CarlitosssT/Tesis-Senecabot/simulacion/geometry_opt/results/linkage_v0218_br_maps.png

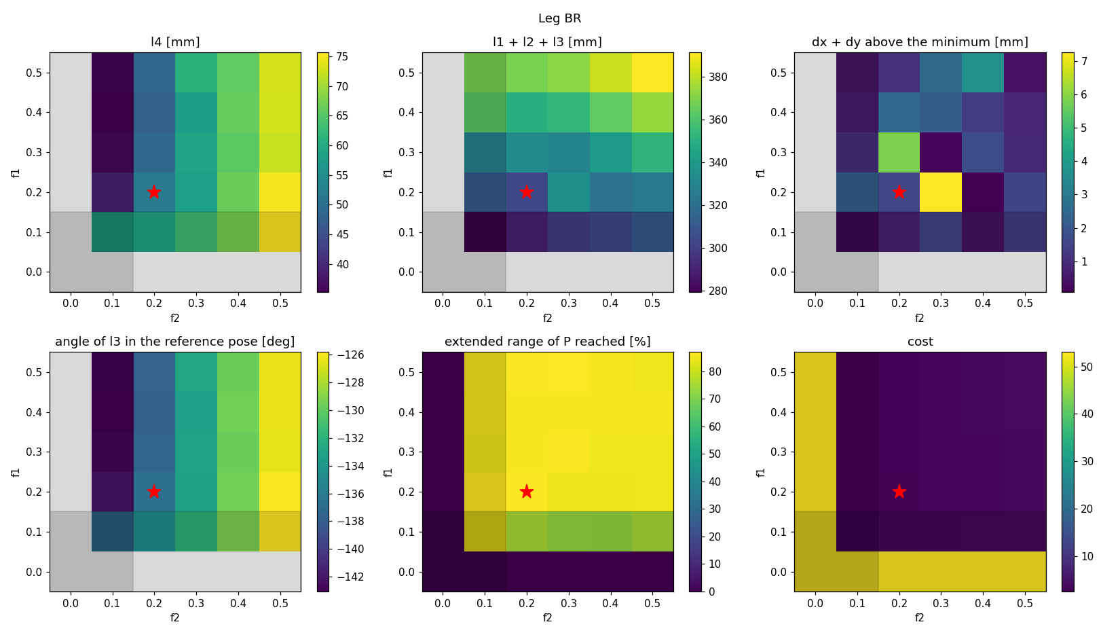
simulacion/geometry_opt/results/linkage_v0218_br_maps.png
