CarlitosssT/Tesis-Senecabot/simulacion/geometry_opt/results/linkage_v140_br_maps.png

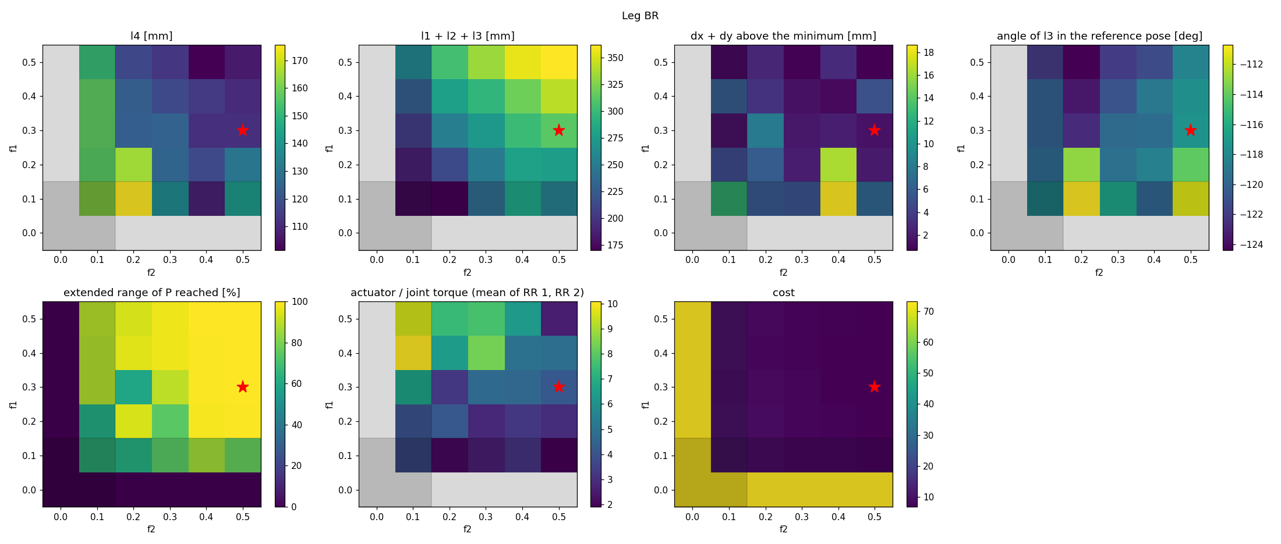
simulacion/geometry_opt/results/linkage_v140_br_maps.png
