CarlitosssT/Tesis-Senecabot/hardware/leg_transmission/leg_motor_angles_one_cycle.csv

time_s | fr_hip_motor | fr_knee_motor | fr_ankle_motor | fl_hip_motor | fl_knee_motor | fl_ankle_motor | br_hip_motor | br_knee_motor | br_ankle_motor | bl_hip_motor | bl_knee_motor | bl_ankle_motor
0.0000 | 40.8251 | -51.0142 | 89.8326 | 55.4209 | -70.9302 | 35.4565 | -46.0505 | 68.4983 | 22.8941 | -43.3910 | 51.2754 | -10.1909
0.0050 | 40.7122 | -51.6700 | 90.8439 | 55.8056 | -71.0176 | 34.5512 | -45.8379 | 68.3587 | 22.1993 | -43.7348 | 50.6002 | -8.2899
0.0100 | 40.5871 | -52.4167 | 91.5073 | 56.1748 | -71.1229 | 33.5724 | -45.6531 | 68.1821 | 21.4969 | -44.0610 | 50.0015 | -6.2978
0.0150 | 40.4487 | -53.2486 | 91.8306 | 56.5272 | -71.2411 | 32.5229 | -45.4947 | 67.9662 | 20.7894 | -44.3673 | 49.4919 | -4.2333
0.0200 | 40.2975 | -54.1578 | 91.8277 | 56.8616 | -71.3657 | 31.4085 | -45.3610 | 67.7095 | 20.0787 | -44.6524 | 49.0823 | -2.1155
0.0250 | 40.1349 | -55.1345 | 91.5180 | 57.1771 | -71.4888 | 30.2372 | -45.2497 | 67.4121 | 19.3661 | -44.9158 | 48.7815 | 0.0364
0.0300 | 39.9638 | -56.1668 | 90.9264 | 57.4729 | -71.6016 | 29.0190 | -45.1584 | 67.0748 | 18.6526 | -45.1581 | 48.5968 | 2.2037
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
