CarlitosssT/Tesis-Senecabot/hardware/myactuator_esp32/track_fr_hip_motor_20261106_103421.csv

t_cmd_s | cmd_deg | t_meas_s | meas_deg | ref_deg | error_deg
3e-06 | 40.83 | 0.000768 | 40.89 | 40.807758559999996 | 0.08224144000000422
0.005006 | 40.71 | 0.005777 | 40.89 | 40.692759460000005 | 0.1972405399999957
0.010006 | 40.59 | 0.010777 | 40.89 | 40.56559264 | 0.32440736000000214
0.015006 | 40.45 | 0.015777 | 40.89 | 40.425203520000004 | 0.46479647999999685
0.020006 | 40.3 | 0.020777 | 40.88 | 40.27223196 | 0.6077680400000034
0.025006 | 40.13 | 0.025777 | 40.88 | 40.10831106 | 0.7716889400000042
0.030006 | 39.96 | 0.030777 | 40.88 | 39.93651176 | 0.9434882400000006
0.035006 | 39.79 | 0.035777 | 40.87 | 39.760958380000005 | 1.1090416199999922
0.040006 | 39.61 | 0.040777 | 40.87 | 39.5866374 | 1.2833625999999967
0.045006 | 39.44 | 0.045777 | 40.87 | 39.41961098 | 1.4503890199999958
0.050006 | 39.29 | 0.050777 | 40.85 | 39.26635682 | 1.5836431800000028
0.055006 | 39.15 | 0.055759 | 40.85 | 39.13414128 | 1.71585872
0.060003 | 39.04 | 0.060774 | 40.84 | 39.02854944 | 1.8114505600000044
0.065006 | 38.96 | 0.065777 | 40.83 | 38.957379259999996 | 1.8726207400000021
0.070003 | 38.93 | 0.070756 | 40.82 | 38.92616768 | 1.8938323200000013
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
