CarlitosssT/Tesis-Senecabot/hardware/servos/leg_actuator_angles_one_cycle_smooth_n4.csv

time_s | fr_hip_joint | fr_knee_joint | fr_ankle_joint | fl_hip_joint | fl_knee_joint | fl_ankle_joint | br_hip_joint | br_knee_joint | br_ankle_joint | bl_hip_joint | bl_knee_joint | bl_ankle_joint
0.0 | 40.38701487145325 | 92.06070460431222 | 139.68104024879875 | 55.420933 | 126.35109 | 106.38661 | -46.05054 | -114.548874 | -45.60422 | -43.391018 | -94.66641 | -61.466324
0.005 | 40.33558154016885 | 92.52249022583622 | 141.58028578366734 | 55.80559 | 126.823204 | 105.56879 | -45.83786 | -114.1966 | -46.159462 | -43.73483 | -94.335 | -58.890053
0.01 | 40.26754457297821 | 93.08010191479913 | 143.19520915706553 | 56.1748 | 127.29768 | 104.69525 | -45.653084 | -113.83523 | -46.68527 | -44.061005 | -94.06254 | -56.299305
0.015 | 40.18236534982674 | 93.72684785525466 | 144.52798296741648 | 56.527184 | 127.76824 | 103.76399 | -45.49474 | -113.460915 | -47.176815 | -44.367332 | -93.85924 | -53.725178
0.02 | 40.08076920536901 | 94.45440229863391 | 145.58548784768666 | 56.861595 | 128.22725 | 102.77416 | -45.36099 | -113.07054 | -47.630898 | -44.65241 | -93.73466 | -51.197746
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
