CarlitosssT/Tesis-Senecabot/hardware/servos/leg_actuator_angles_trajectory_adapted.csv

time_s | fr_hip_joint | fr_knee_joint | fr_ankle_joint | fl_hip_joint | fl_knee_joint | fl_ankle_joint | br_hip_joint | br_knee_joint | br_ankle_joint | bl_hip_joint | bl_knee_joint | bl_ankle_joint
0.0 | 40.82513 | 91.839325 | 140.84676 | 55.420933 | 126.35109 | 106.38661 | -46.05054 | -114.548874 | -45.60422 | -43.391018 | -94.66641 | -61.466324
0.005 | 40.71224 | 92.3822 | 142.51387 | 55.80559 | 126.823204 | 105.56879 | -45.83786 | -114.1966 | -46.159462 | -43.73483 | -94.335 | -58.890053
0.01 | 40.58707 | 93.003784 | 143.92398 | 56.1748 | 127.29768 | 104.69525 | -45.653084 | -113.83523 | -46.68527 | -44.061005 | -94.06254 | -56.299305
0.015 | 40.44872 | 93.69732 | 145.07922 | 56.527184 | 127.76824 | 103.76399 | -45.49474 | -113.460915 | -47.176815 | -44.367332 | -93.85924 | -53.725178
0.02 | 40.297466 | 94.455315 | 145.9855 | 56.861595 | 128.22725 | 102.77416 | -45.36099 | -113.07054 | -47.630898 | -44.65241 | -93.73466 | -51.197746
0.025 | 40.134907 | 95.26939 | 146.65251 | 57.17709 | 128.66591 | 101.726006 | -45.249664 | -112.6618 | -48.04599 | -44.915833 | -93.69737 | -48.745155
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
