CarlitosssT/Tesis-Senecabot/hardware/leg_transmission/leg_transmission.png

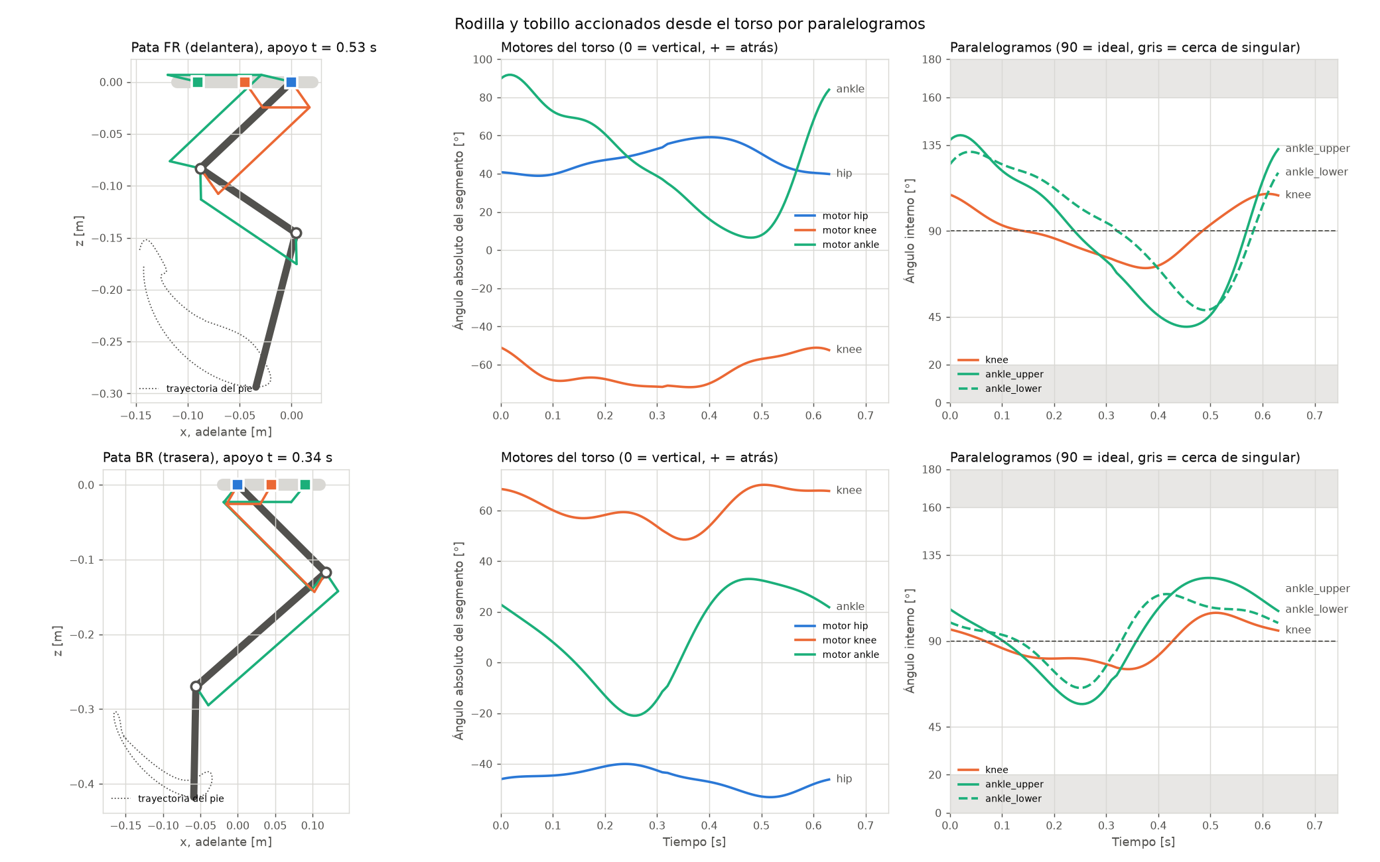
hardware/leg_transmission/leg_transmission.png
