CarlitosssT/Tesis-Senecabot/hardware/leg_transmission/mecanismo.png

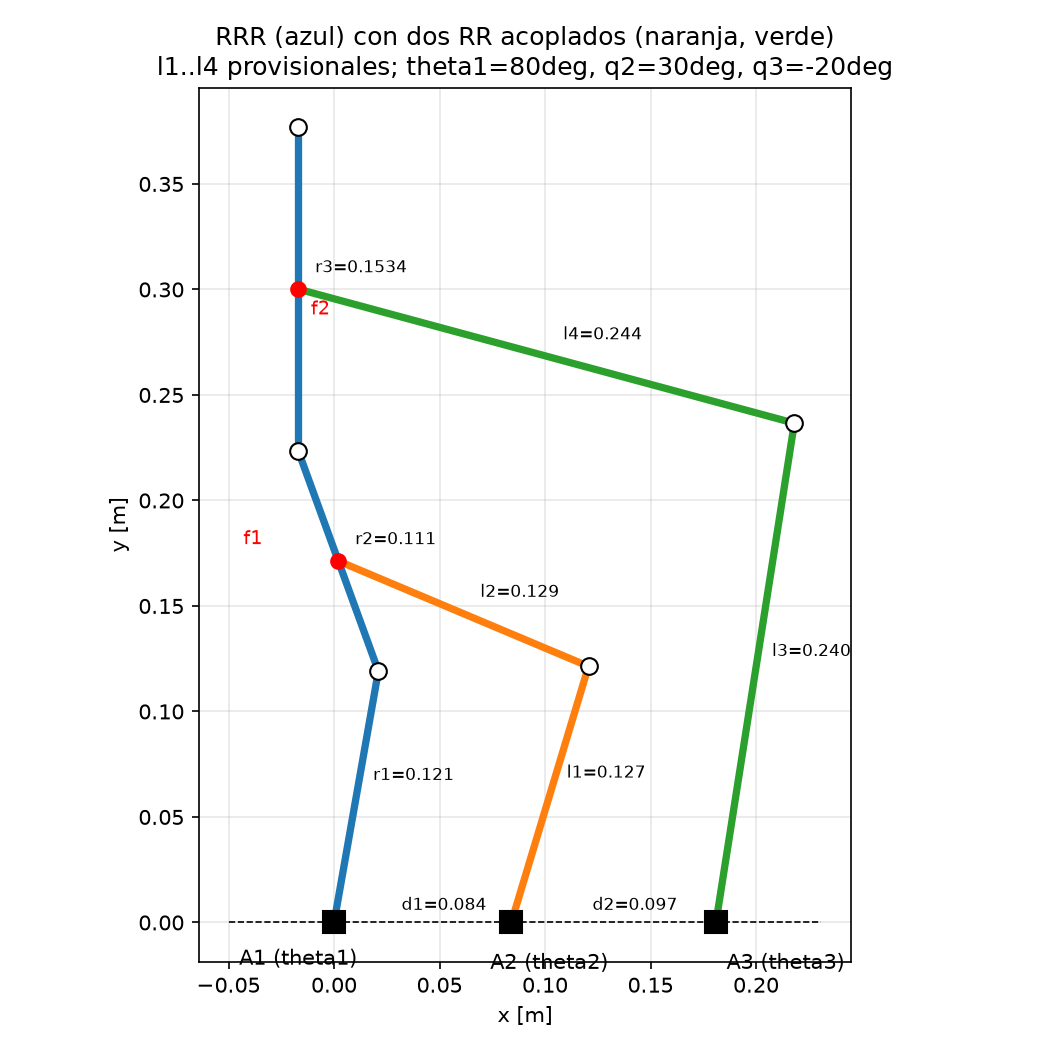
hardware/leg_transmission/mecanismo.png
