CarlitosssT/Tesis-Senecabot/hardware/leg_transmission/mecanismo_br.gif

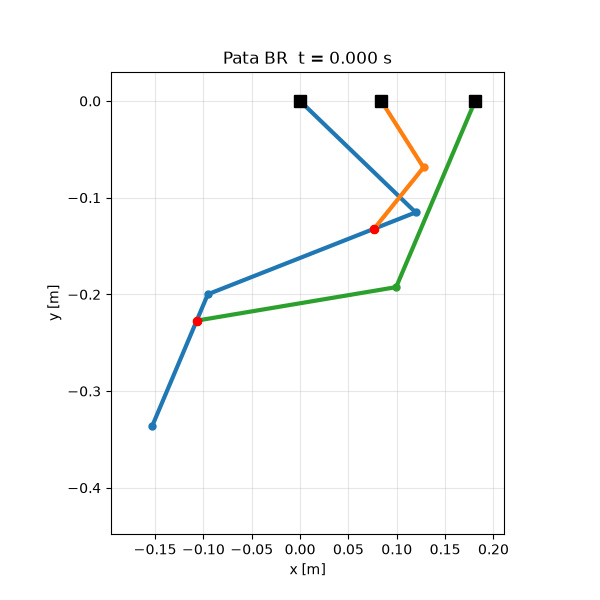
hardware/leg_transmission/mecanismo_br.gif
