CarlitosssT/Tesis-Senecabot/hardware/leg_transmission/mecanismo_fr.gif

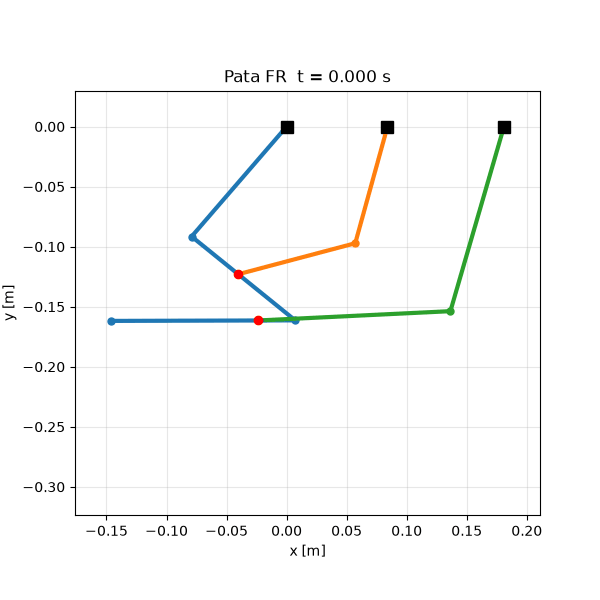
hardware/leg_transmission/mecanismo_fr.gif
