CarlitosssT/Tesis-Senecabot/hardware/leg_transmission/mecanismo_v2_br.gif

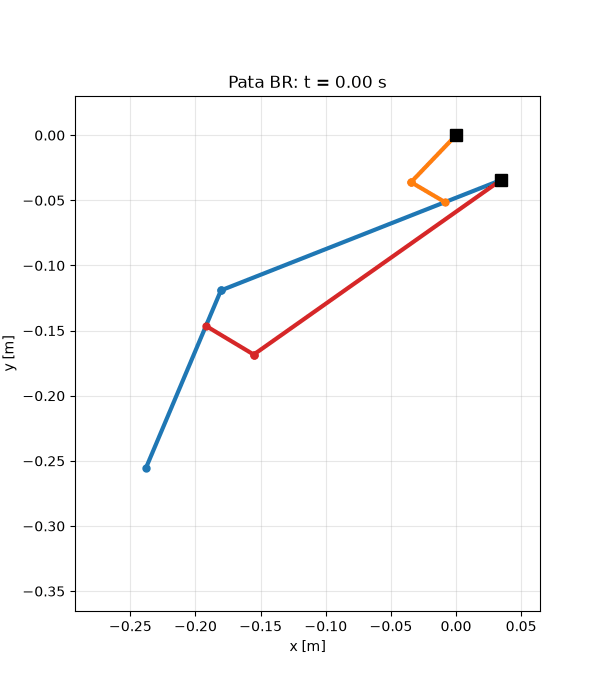
hardware/leg_transmission/mecanismo_v2_br.gif
