CarlitosssT/Tesis-Senecabot/hardware/leg_transmission/mecanismo_v2_fr.gif

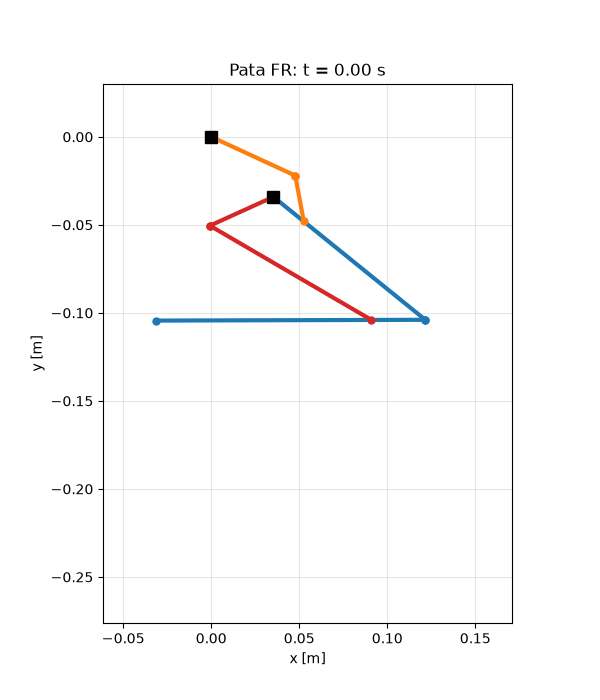
hardware/leg_transmission/mecanismo_v2_fr.gif
