CarlitosssT/Tesis-Senecabot/hardware/myactuator_esp32/sysid/sysid_preview.png

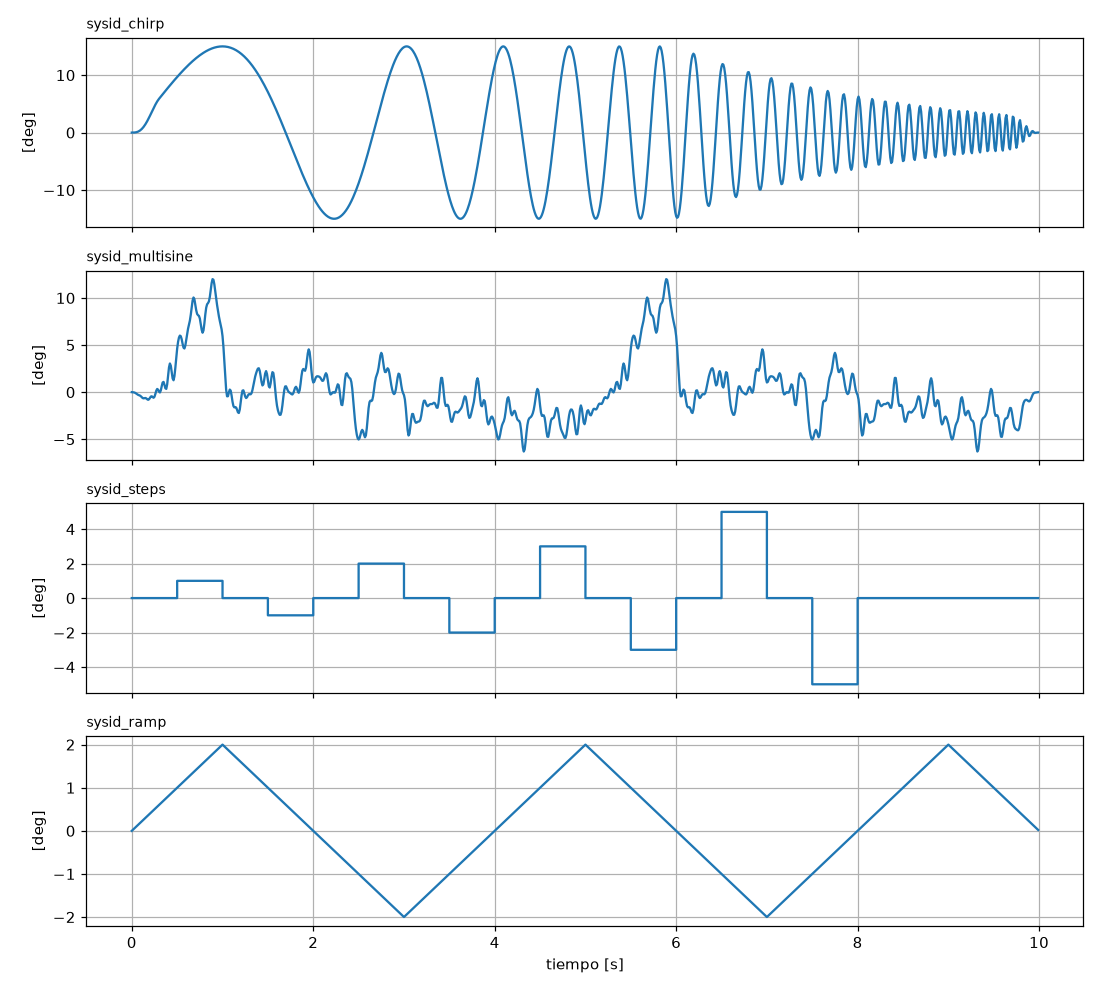
hardware/myactuator_esp32/sysid/sysid_preview.png
