CarlitosssT/Tesis-Senecabot/hardware/myactuator_esp32/track_fr_hip_motor_20261106_103421.png

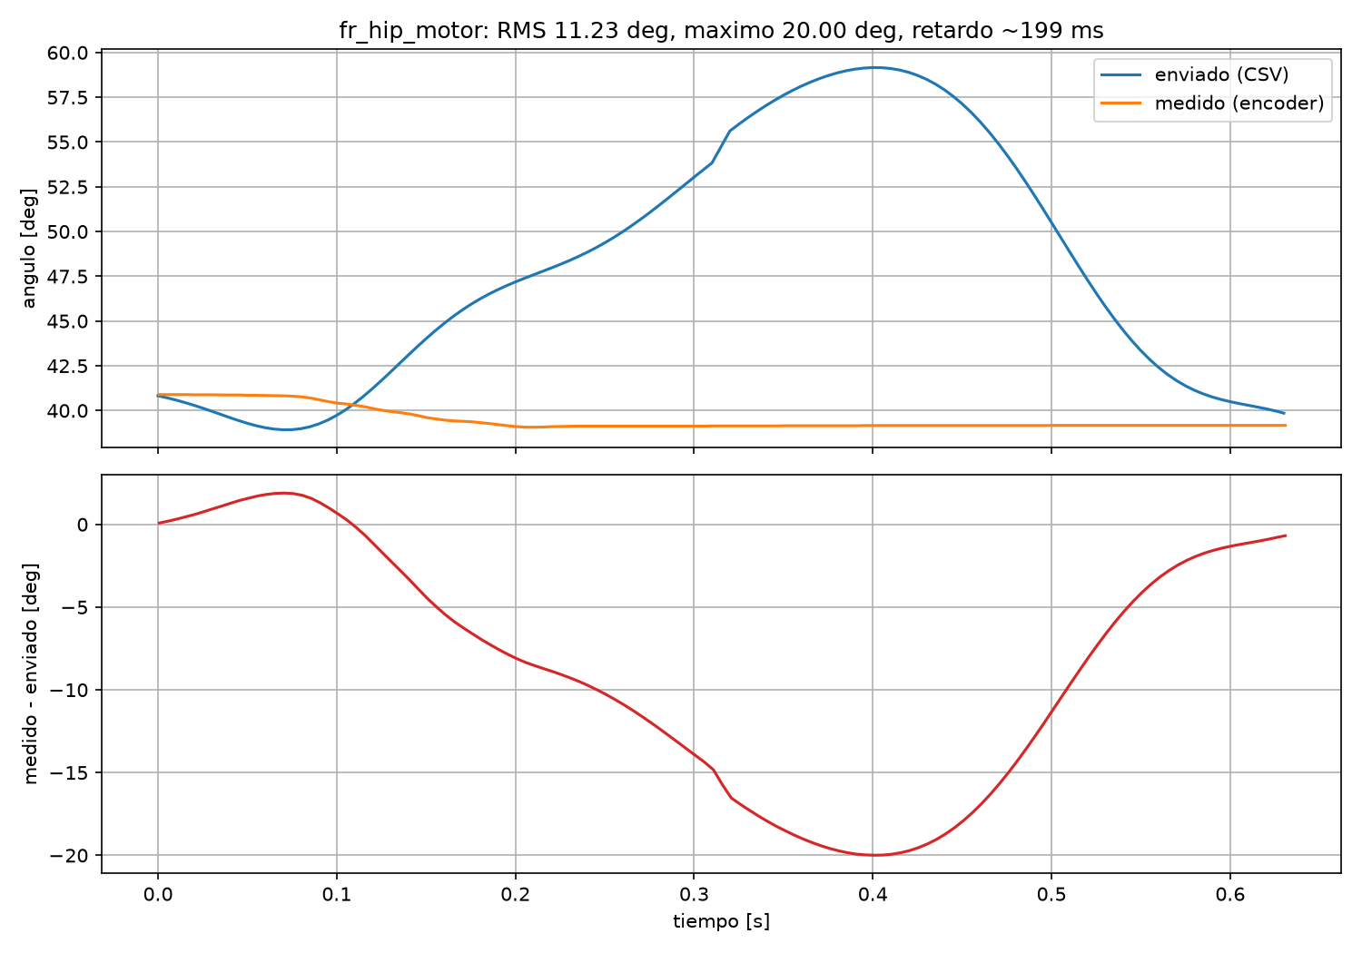
hardware/myactuator_esp32/track_fr_hip_motor_20261106_103421.png
