CarlitosssT/Tesis-Senecabot/hardware/servos/fr_leg_initial_pose.png

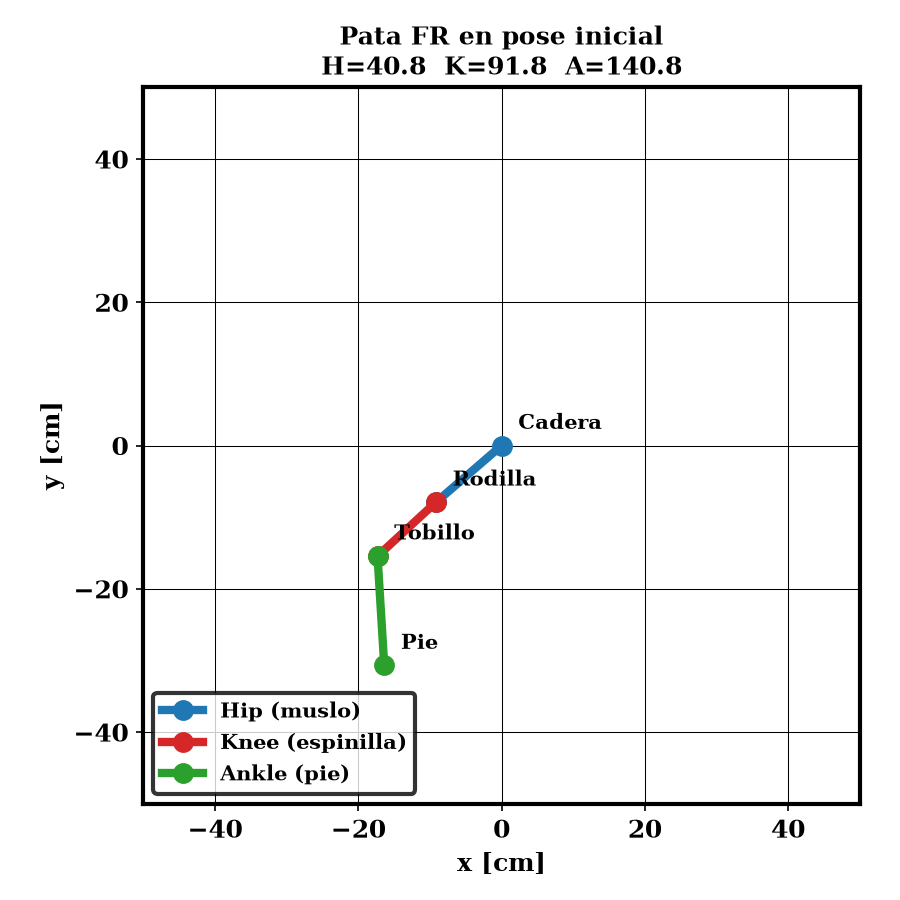
hardware/servos/fr_leg_initial_pose.png
