CarlitosssT/Tesis-Senecabot/simulacion/analisis/microsaltos/altura_patas_100M.png

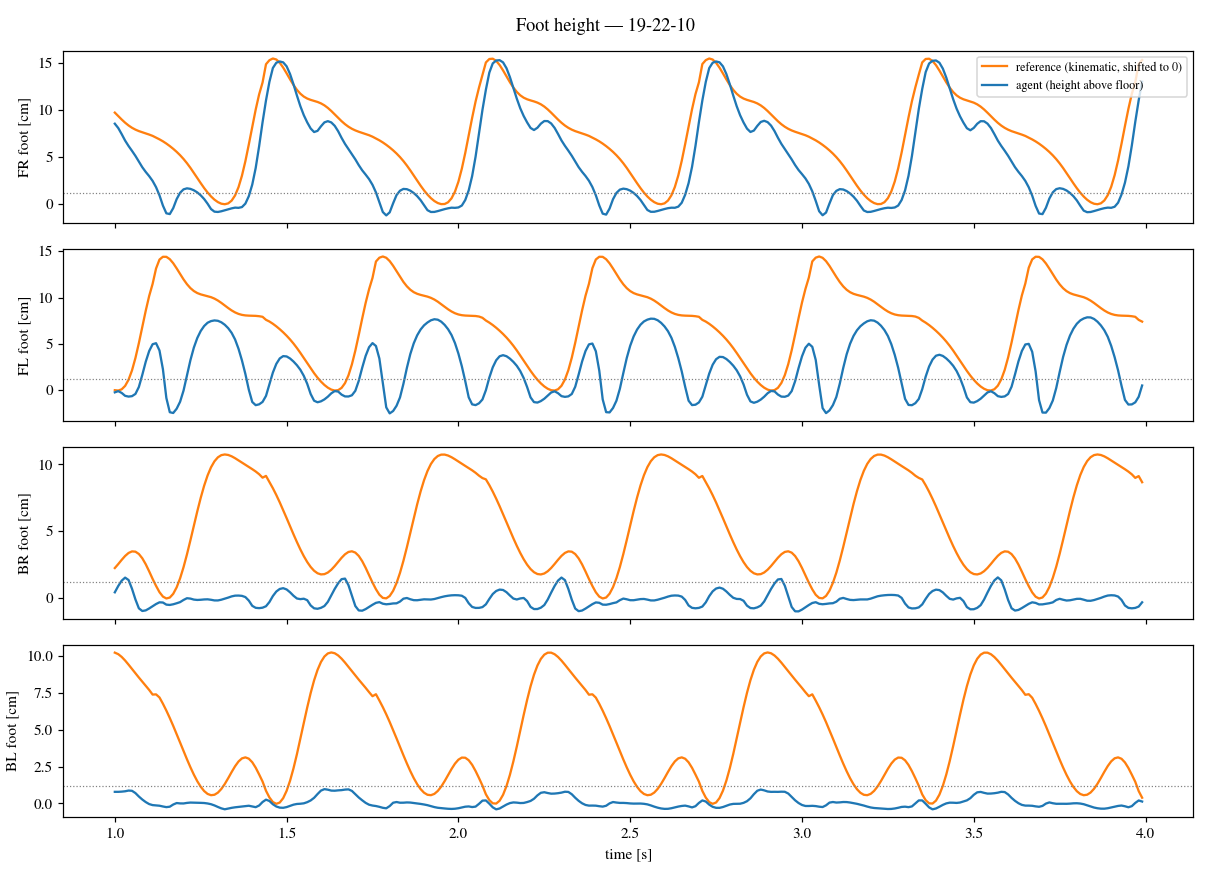
simulacion/analisis/microsaltos/altura_patas_100M.png
