CarlitosssT/Tesis-Senecabot/simulacion/analisis/microsaltos/altura_patas_100M_v1.png

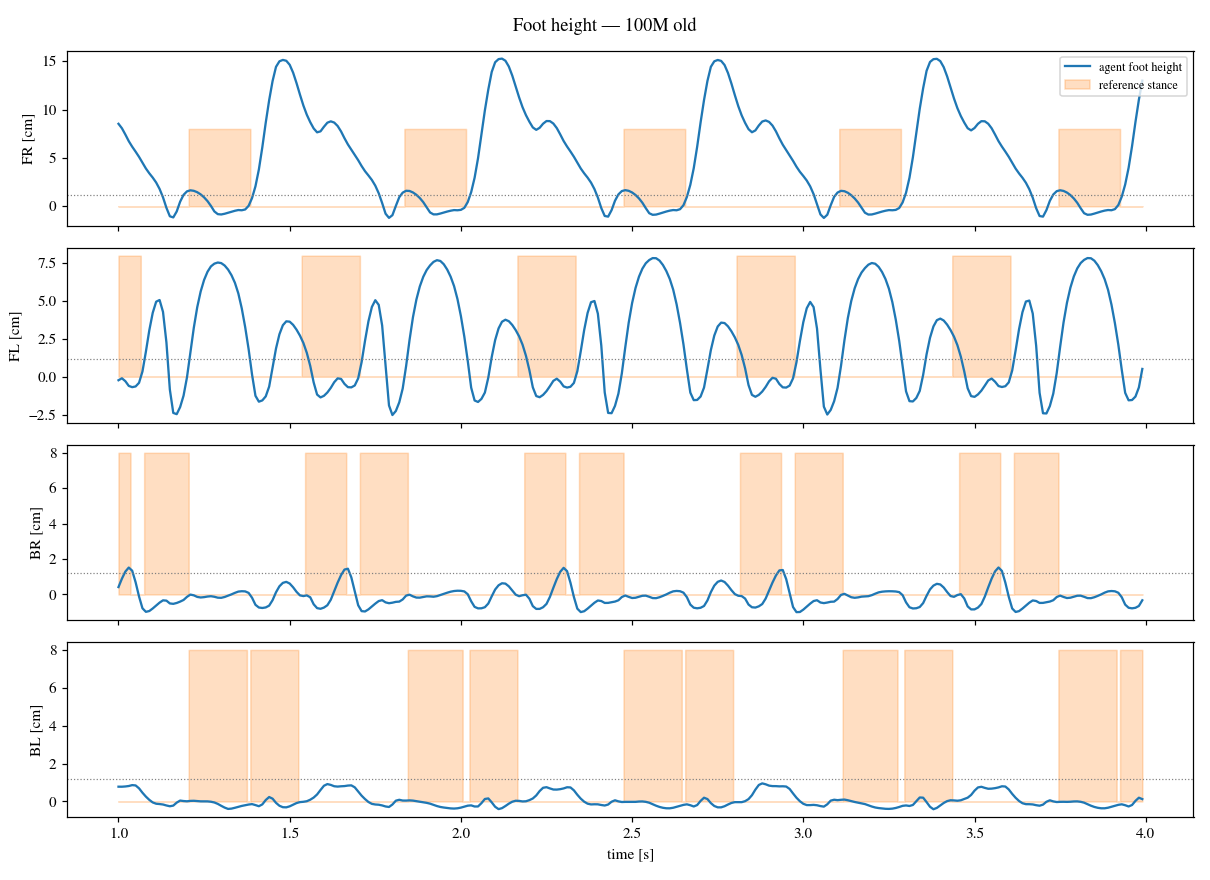
simulacion/analisis/microsaltos/altura_patas_100M_v1.png
