CarlitosssT/Tesis-Senecabot/simulacion/analisis/microsaltos/altura_patas_100M_v2.png

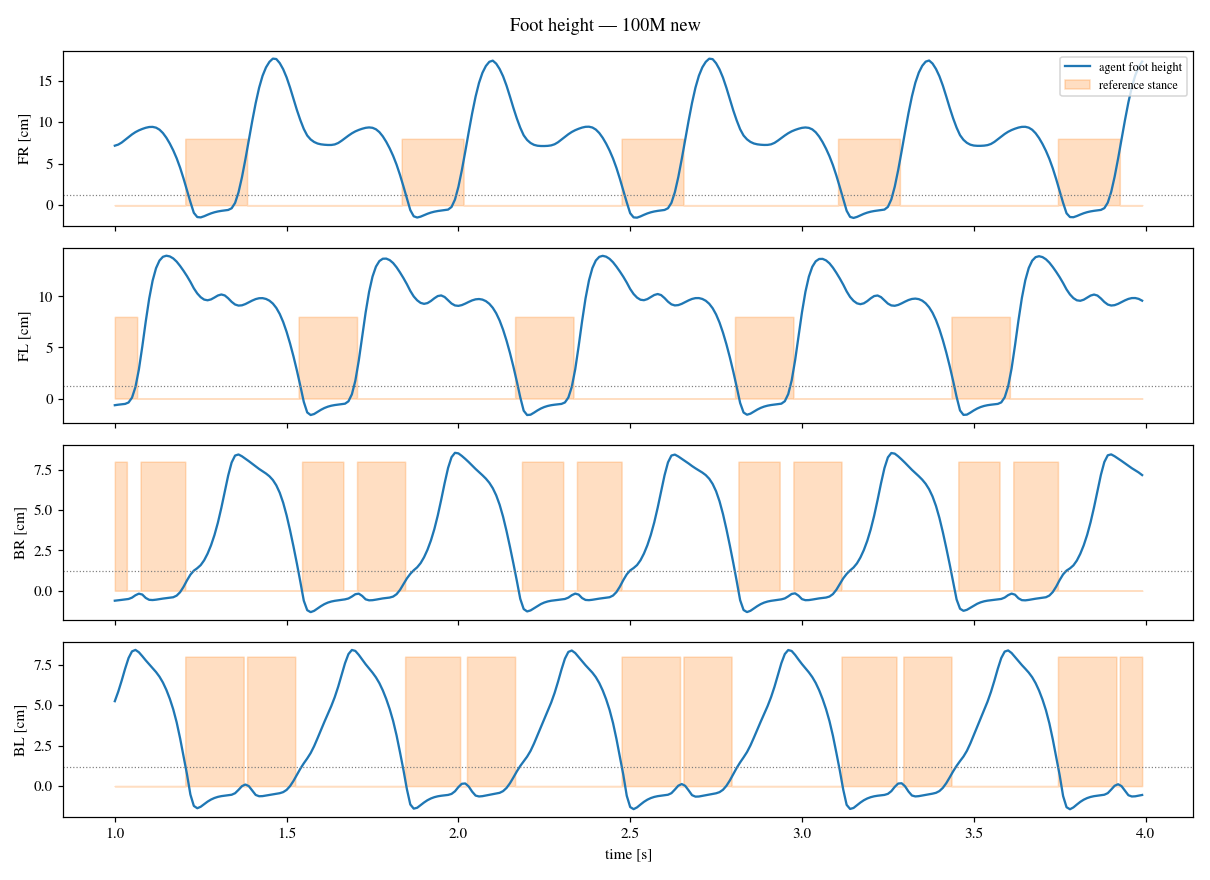
simulacion/analisis/microsaltos/altura_patas_100M_v2.png
