CarlitosssT/Tesis-Senecabot/simulacion/analisis/microsaltos/altura_patas_100M_v3_1p4.png

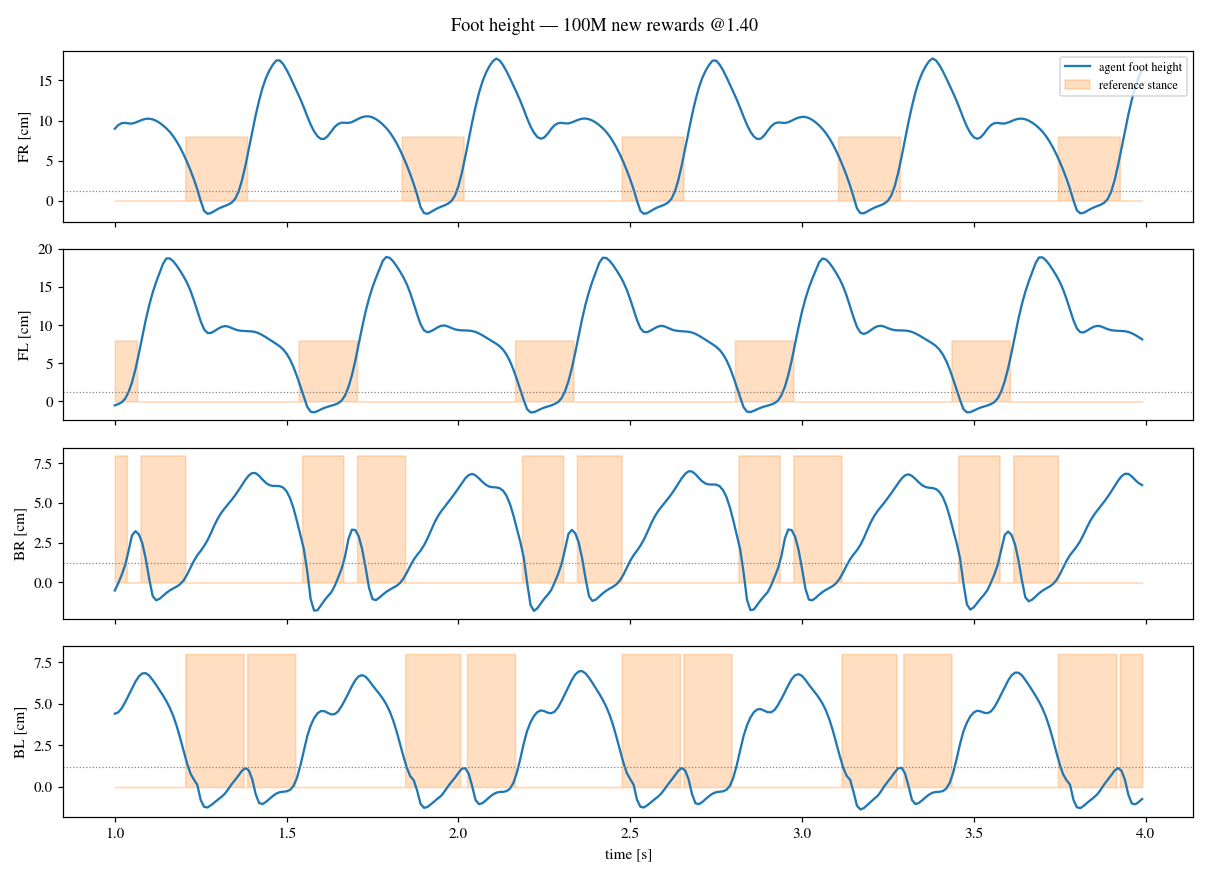
simulacion/analisis/microsaltos/altura_patas_100M_v3_1p4.png
