CarlitosssT/Tesis-Senecabot/simulacion/analisis/microsaltos/altura_patas_300M.png

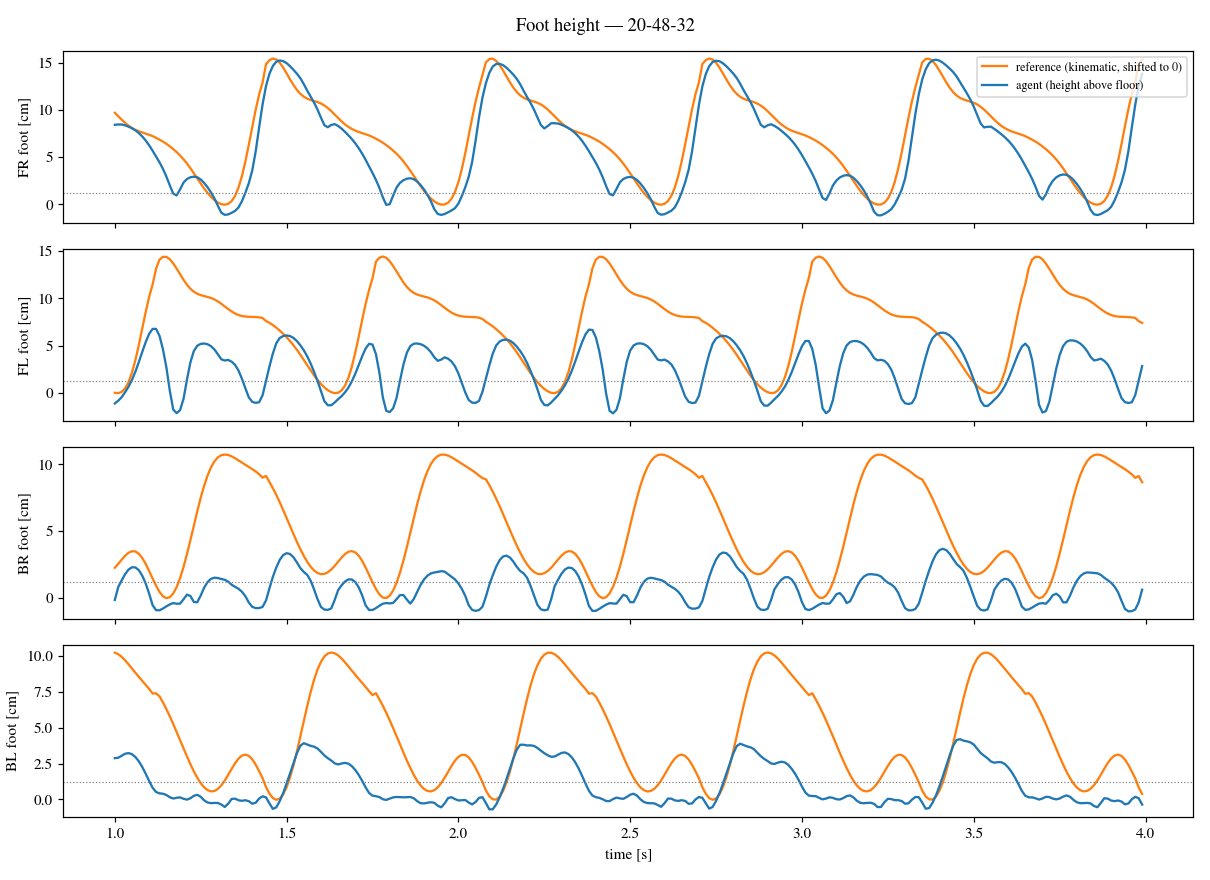
simulacion/analisis/microsaltos/altura_patas_300M.png
