CarlitosssT/Tesis-Senecabot/simulacion/analisis/pata_rr/geometria_rr_actual.png

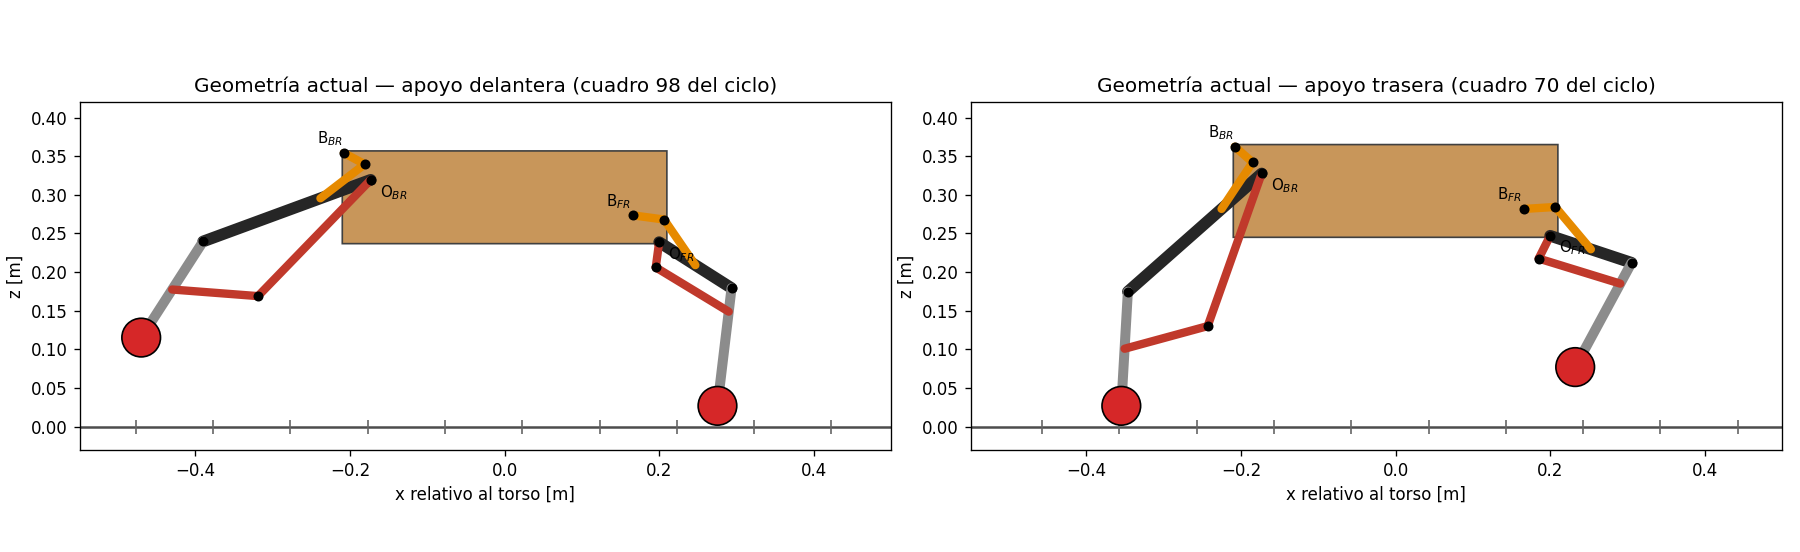
simulacion/analisis/pata_rr/geometria_rr_actual.png
