CarlitosssT/Tesis-Senecabot/simulacion/analisis/pata_rr/patas_rr_10-10-34.gif

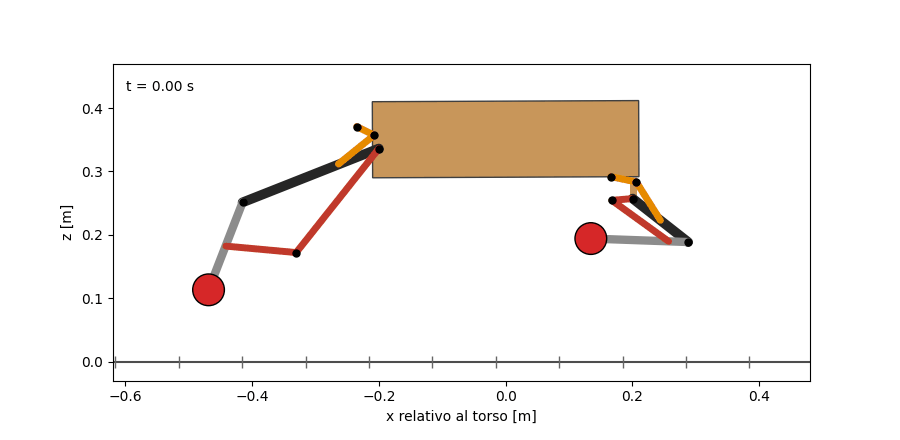
simulacion/analisis/pata_rr/patas_rr_10-10-34.gif
