CarlitosssT/Tesis-Senecabot/simulacion/analisis/pata_rr/patas_rr_16-41-28.gif

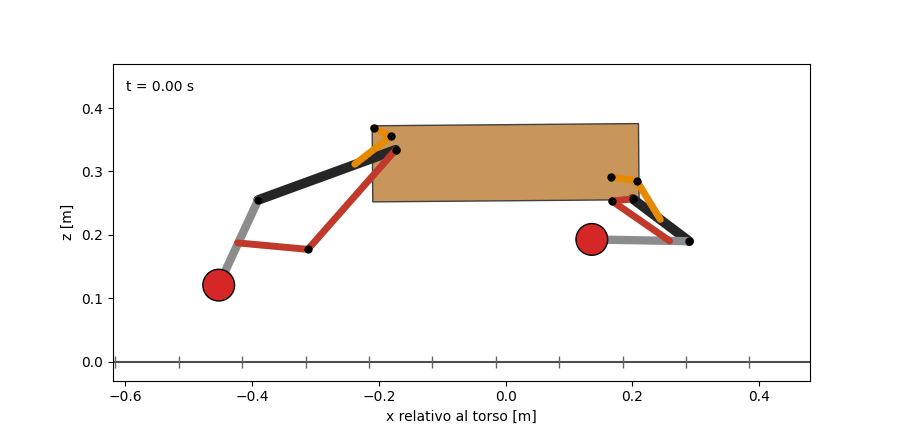
simulacion/analisis/pata_rr/patas_rr_16-41-28.gif
