CarlitosssT/Tesis-Senecabot/simulacion/geometry_opt/results/linkage_v140_fr_design.png

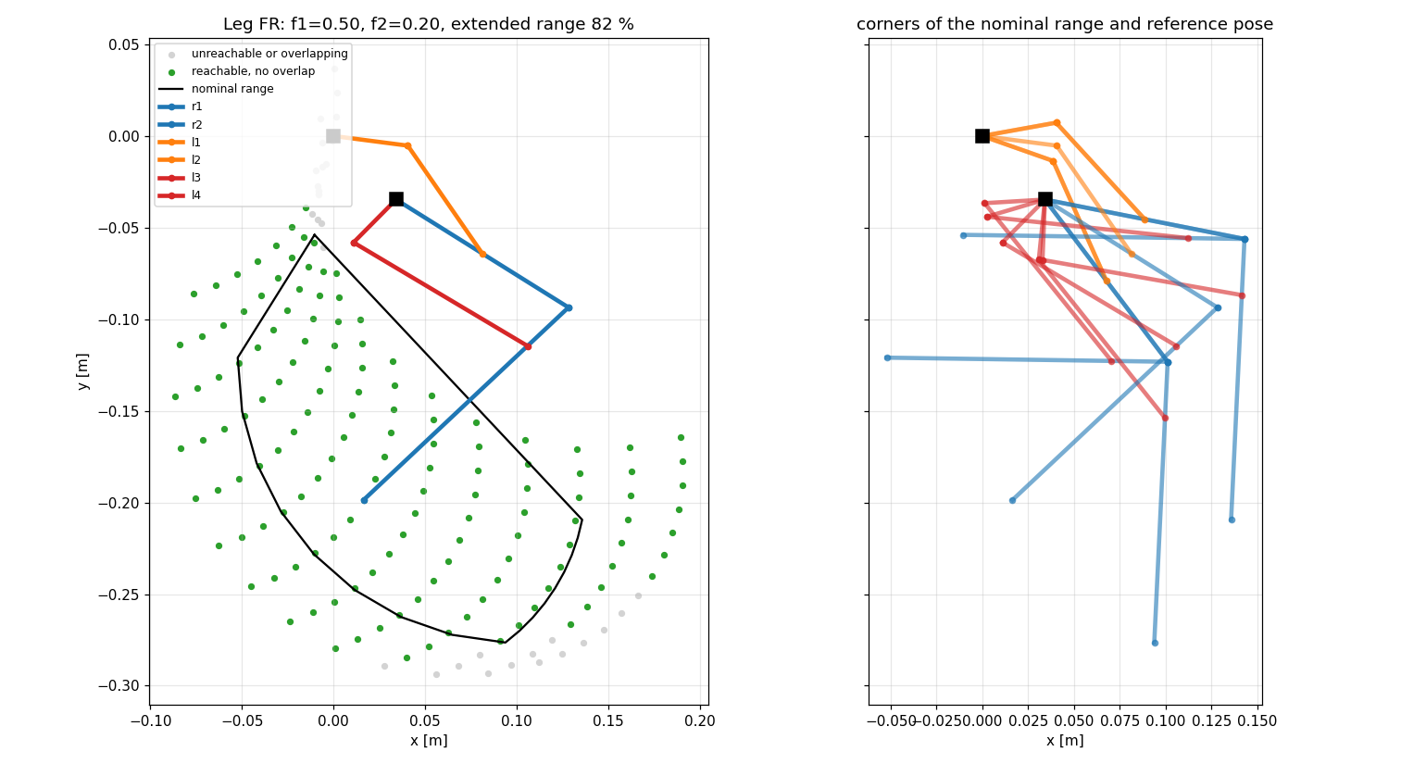
simulacion/geometry_opt/results/linkage_v140_fr_design.png
