CarlitosssT/Tesis-Senecabot/simulacion/geometry_opt/results/linkage_v0218_br_design.png

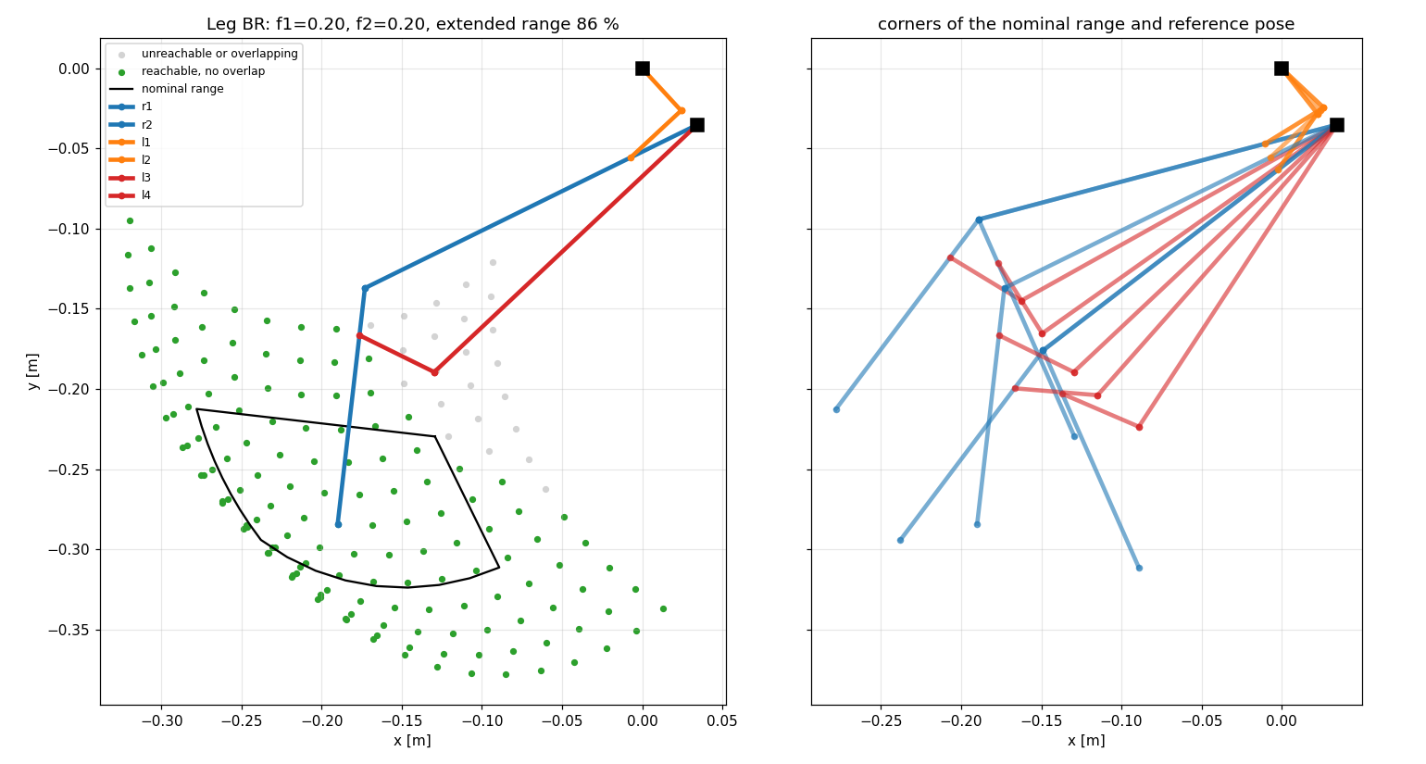
simulacion/geometry_opt/results/linkage_v0218_br_design.png
