CarlitosssT/Tesis-Senecabot/simulacion/geometry_opt/results/linkage_v0218_fr_design.png

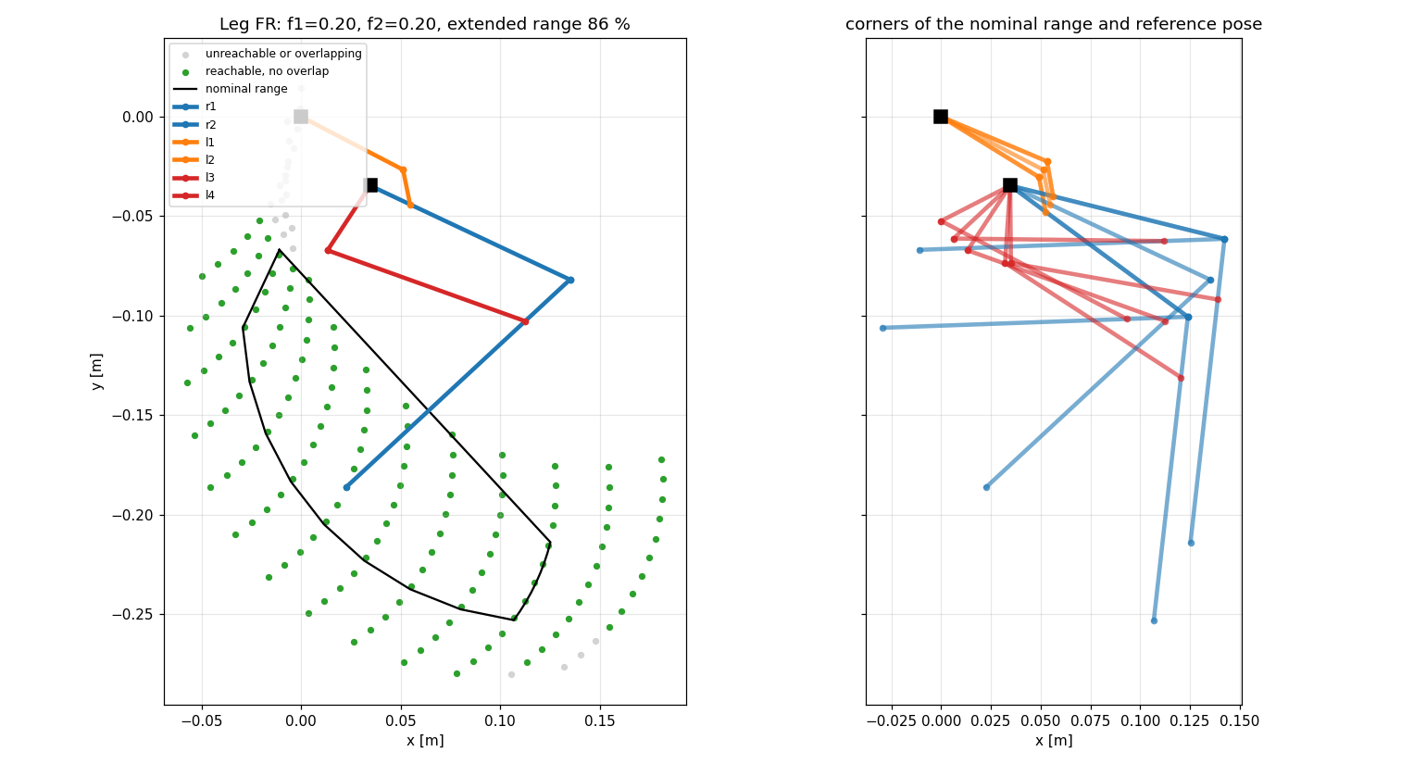
simulacion/geometry_opt/results/linkage_v0218_fr_design.png
