CarlitosssT/Tesis-Senecabot/simulacion/loco-mujoco-seneca/docs/source/images/locomujoco_pipeline.png

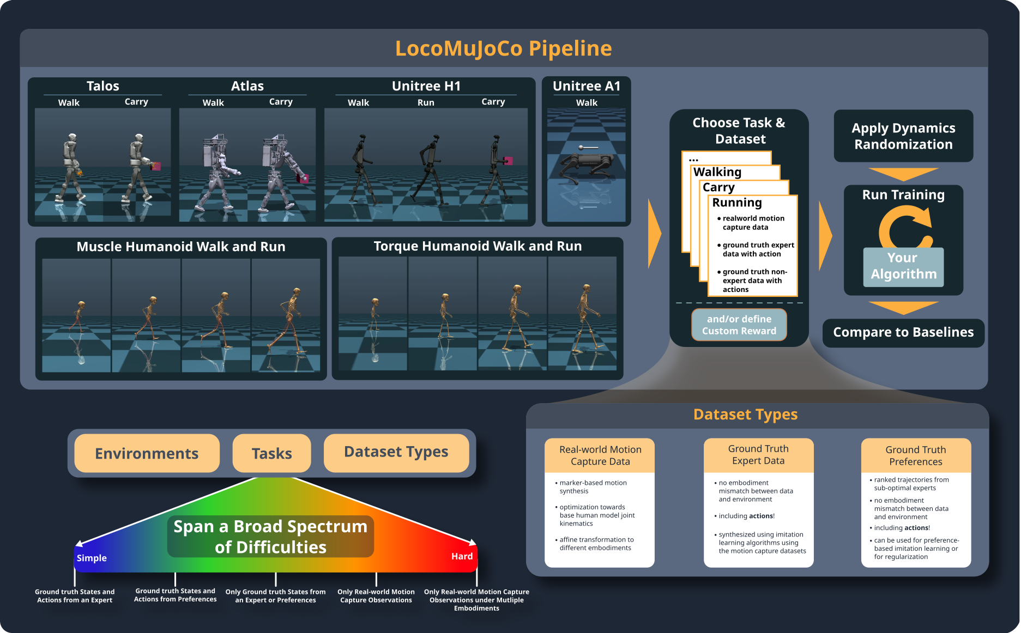
simulacion/loco-mujoco-seneca/docs/source/images/locomujoco_pipeline.png
