CarlitosssT/Tesis-Senecabot/simulacion/seneca_loco/final_document/images/schematic__leg_naming__v1.png

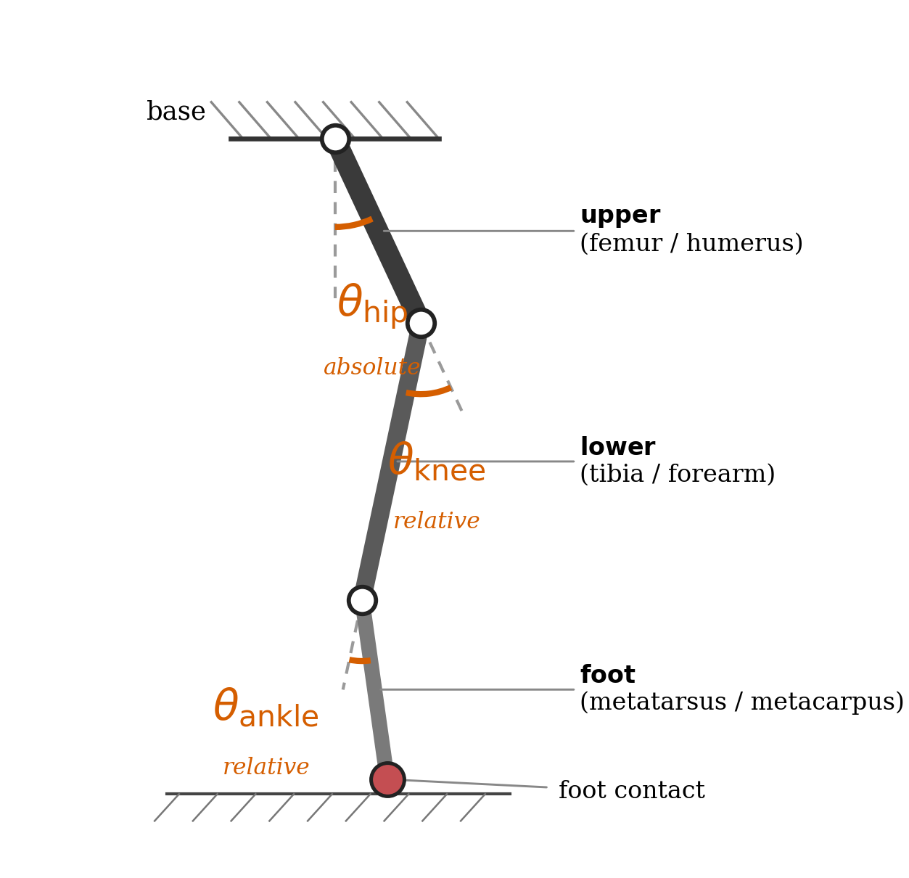
simulacion/seneca_loco/final_document/images/schematic__leg_naming__v1.png
