CarlitosssT/Tesis-Senecabot/simulacion/seneca_loco/final_document/images/schematic__project_overview__v1.png

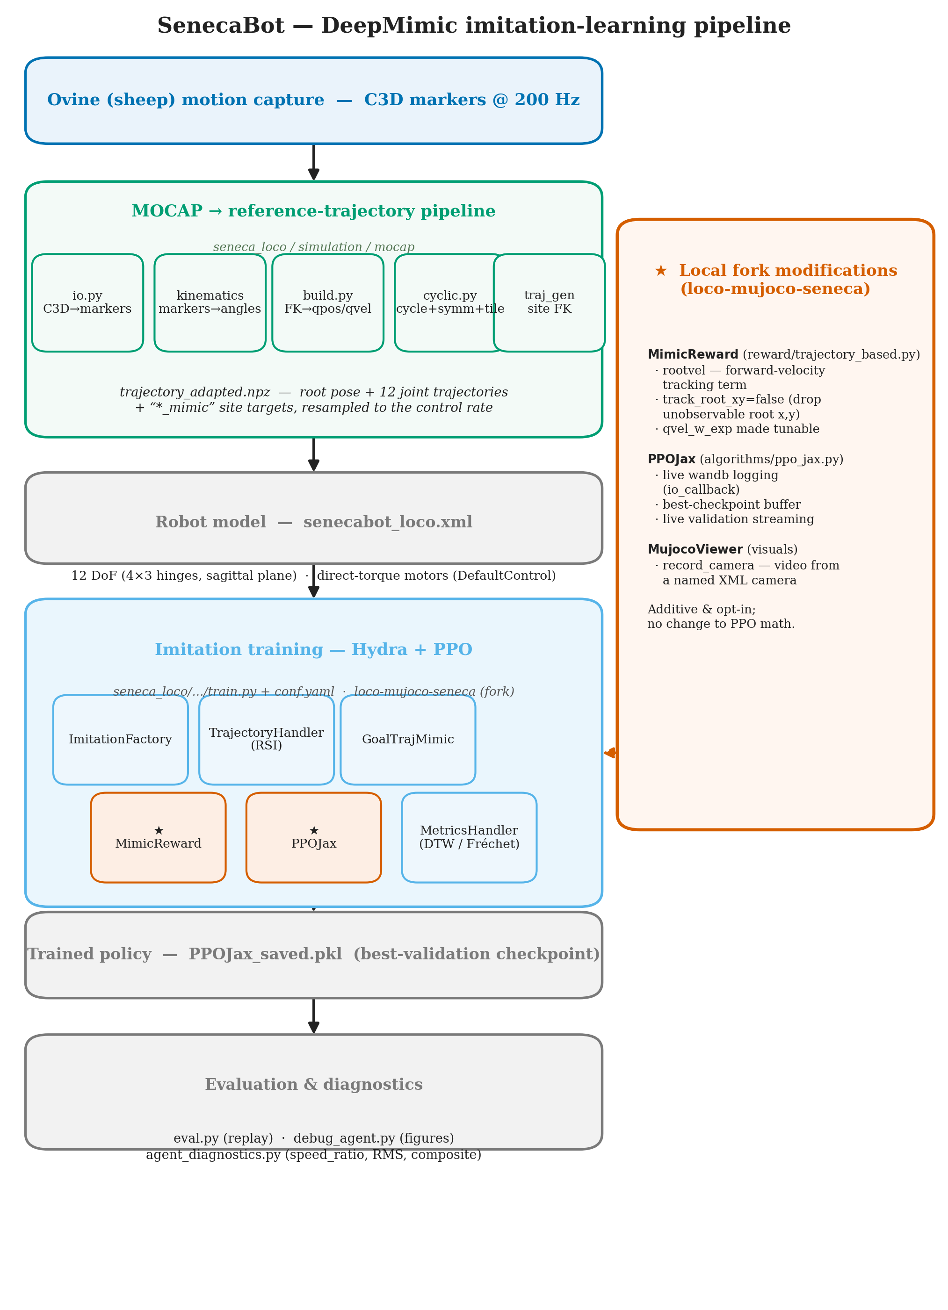
simulacion/seneca_loco/final_document/images/schematic__project_overview__v1.png
