CarlitosssT/Tesis-Senecabot/simulacion/seneca_loco/final_document/images/schematic__robot_model__diagonal.png

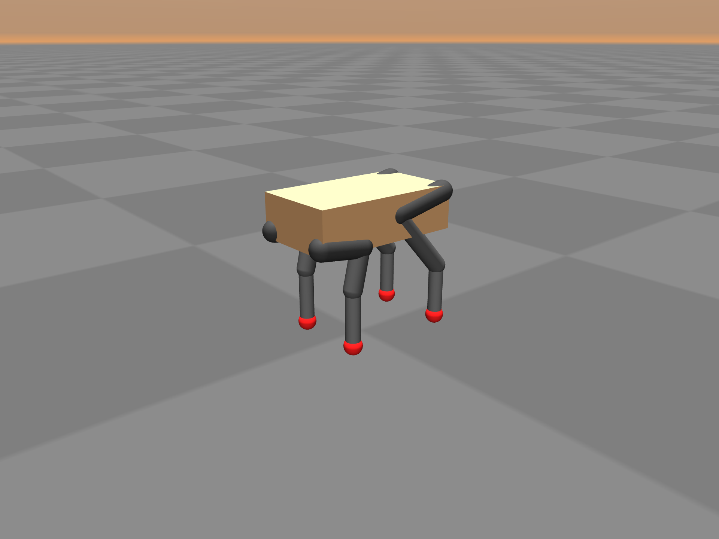
simulacion/seneca_loco/final_document/images/schematic__robot_model__diagonal.png
