CarlitosssT/Tesis-Senecabot/simulacion/seneca_loco/final_document/images/schematic__robot_model__front.png

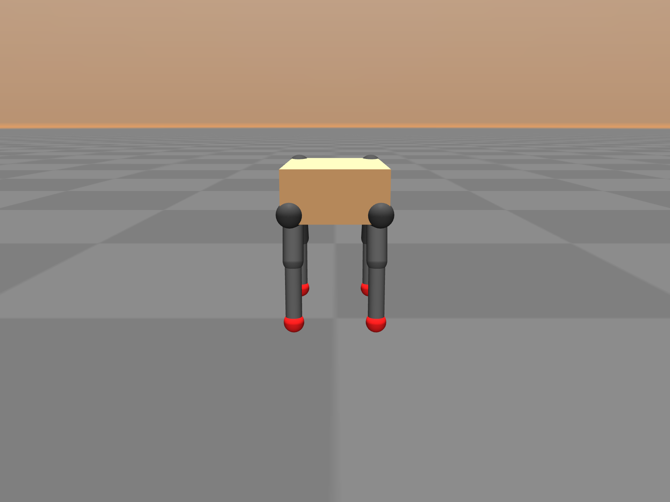
simulacion/seneca_loco/final_document/images/schematic__robot_model__front.png
