CarlitosssT/Tesis-Senecabot/simulacion/seneca_loco/final_document/images/training__episode_length__v1.png

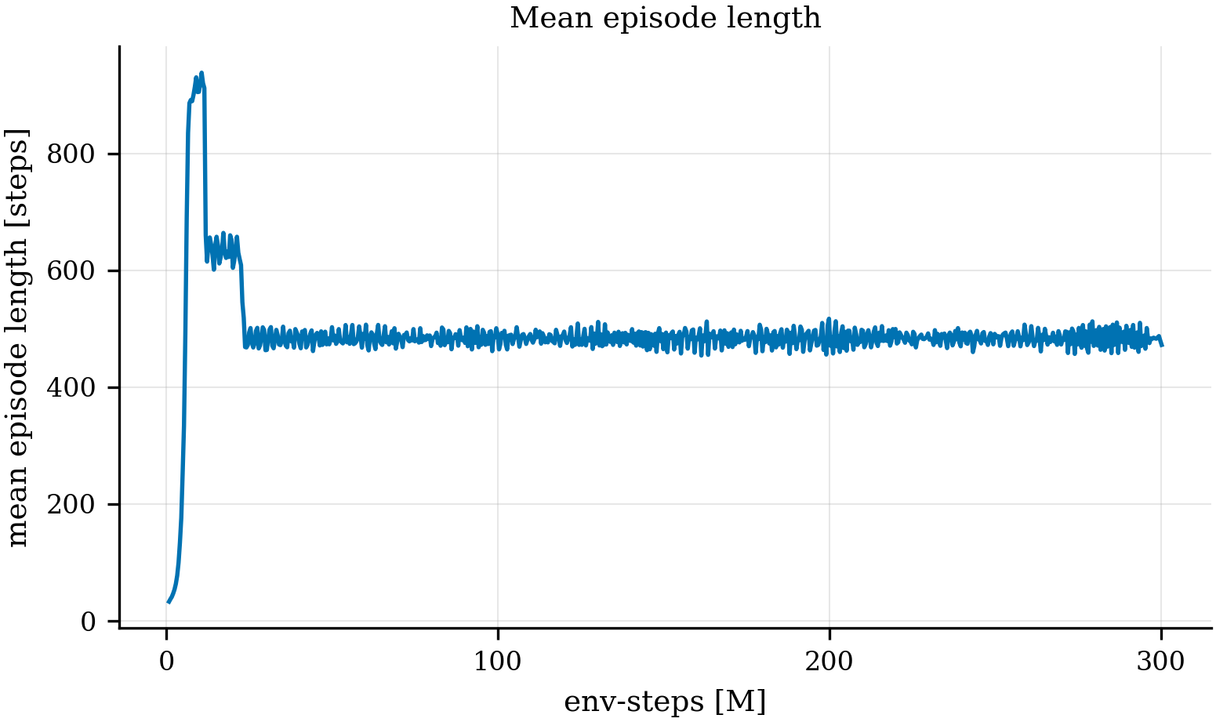
simulacion/seneca_loco/final_document/images/training__episode_length__v1.png
