CarlitosssT/Tesis-Senecabot/simulacion/seneca_loco/final_document/images/training__episode_return__v1.png

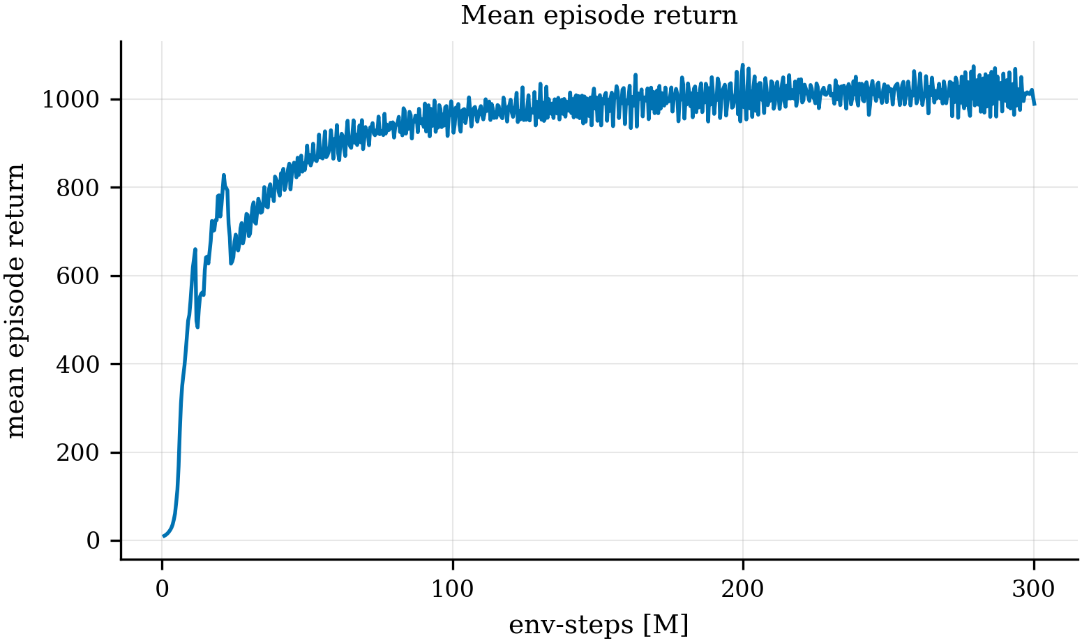
simulacion/seneca_loco/final_document/images/training__episode_return__v1.png
