CarlitosssT/Tesis-Senecabot/simulacion/seneca_loco/final_document/images/training__metric_for_sweep__v1.png

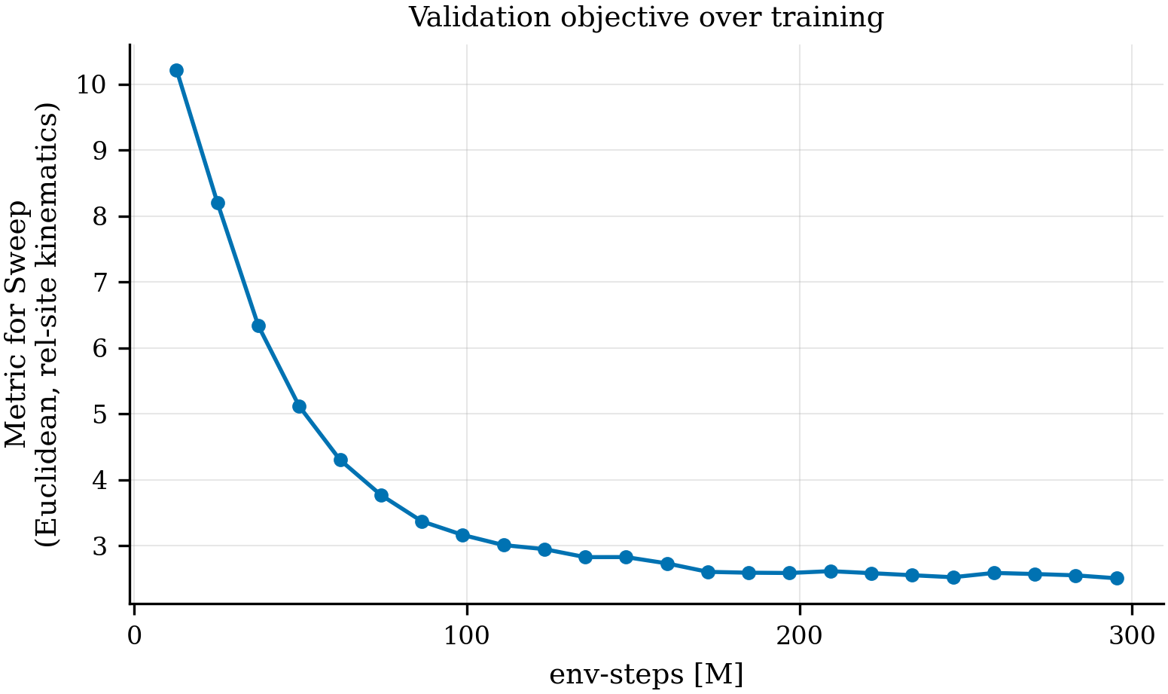
simulacion/seneca_loco/final_document/images/training__metric_for_sweep__v1.png
