CarlitosssT/Tesis-Senecabot/simulacion/seneca_loco/final_document/images/training__policy_entropy__v1.png

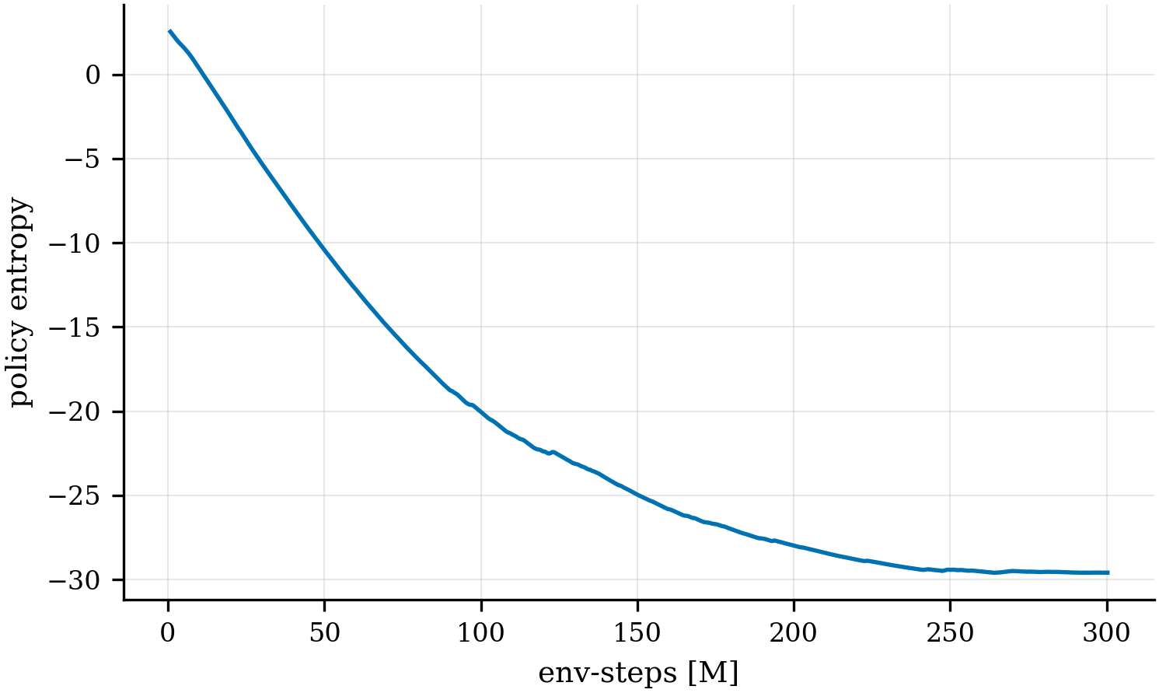
simulacion/seneca_loco/final_document/images/training__policy_entropy__v1.png
