CarlitosssT/Tesis-Senecabot/simulacion/geometry_opt/results/linkage_actuators_v140_PLA.csv

actuator | leg | tau_max | tau_rms | omega_max_rpm | joint | joint_tau_max | joint_tau_rms | joint_omega_max_rpm | min_abs_det_G | power_error | model | motor_mass | motor_peak | motor_nominal | motor_speed | feasible | binding | direct_model | direct_mass
fr_rr1 | fr | 71.40867636784445 | 16.914177775546705 | 91.39800280949422 | knee | 35.92187468903828 | 8.742325803212136 | 160.27377319335938 | 0.3934790294021162 | 2.2737367544323206e-13 | X8-102 19,612:1 | 1.4 | 120.0 | 43.0 | 158.0 | True | peak torque | X6-60 19,612:1 | 0.82
fr_rr2 | fr | 14.568027410303653 | 3.7730940487381894 | 135.76120745813364 | ankle | 13.531288355764982 | 3.451048950880617 | 178.30967712402344 | 0.3934790294021162 | 2.2737367544323206e-13 | X8-32 9:1 | 0.55 | 32.0 | 8.0 | 277.0 | True | RMS torque | X8-32 9:1 | 0.55
br_rr1 | br | 94.90333348888181 | 27.94560971701609 | 42.010158908970524 | knee | 22.344479853805538 | 7.872851788401835 | 61.40249252319336 | 0.14657723470820294 | 5.684341886080802e-14 | X8-102 19,612:1 | 1.4 | 120.0 | 43.0 | 158.0 | True | peak torque | X4-36 36:1 | 0.36
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
