CarlitosssT/Tesis-Senecabot/simulacion/geometry_opt/results/motors_v0218_PETG.csv

joint | model | mass | peak | nominal | speed | feasible | binding | req_peak | req_nominal | req_speed
fr_hip | X4-36 36:1 | 0.36 | 34.0 | 10.5 | 111.0 | True | speed | 9.647249458952766 | 4.259913453843712 | 59.04548645019531
fr_knee | X6-60 19,612:1 | 0.82 | 60.0 | 20.0 | 176.0 | True | speed | 36.686268943051 | 9.46359976062237 | 124.80070495605469
fr_ankle | X8-32 9:1 | 0.55 | 32.0 | 8.0 | 277.0 | True | speed | 13.753804203656403 | 3.503866419454851 | 176.05889892578125
fl_hip | X4-36 36:1 | 0.36 | 34.0 | 10.5 | 111.0 | True | speed | 12.960563164100805 | 4.454656586254096 | 57.19969177246094
fl_knee | X4-36 36:1 | 0.36 | 34.0 | 10.5 | 111.0 | True | speed | 30.982401733999772 | 9.301282548934598 | 104.72349548339844
fl_ankle | X8-32 9:1 | 0.55 | 32.0 | 8.0 | 277.0 | True | speed | 14.323695771653886 | 3.513715790554764 | 227.09469604492188
br_hip | X4-36 36:1 | 0.36 | 34.0 | 10.5 | 111.0 | True | peak torque | 12.13109632559703 | 3.7134391672614084 | 35.17333984375
br_knee | X4-36 36:1 | 0.36 | 34.0 | 10.5 | 111.0 | True | RMS torque | 20.7779325599917 | 8.5141648885293 | 67.24100494384766
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
