CarlitosssT/Tesis-Senecabot/simulacion/geometry_opt/results/motors_v0218_PLA.csv

joint | model | mass | peak | nominal | speed | feasible | binding | req_peak | req_nominal | req_speed
fr_hip | X4-36 36:1 | 0.36 | 34.0 | 10.5 | 111.0 | True | speed | 9.651132888234637 | 4.2550812098716015 | 59.04548645019531
fr_knee | X6-60 19,612:1 | 0.82 | 60.0 | 20.0 | 176.0 | True | speed | 36.65846580374274 | 9.45313067098966 | 124.80070495605469
fr_ankle | X8-32 9:1 | 0.55 | 32.0 | 8.0 | 277.0 | True | speed | 13.693612741693096 | 3.4923823255719335 | 176.05889892578125
fl_hip | X4-36 36:1 | 0.36 | 34.0 | 10.5 | 111.0 | True | speed | 12.949401575927414 | 4.452836137807768 | 57.19969177246094
fl_knee | X4-36 36:1 | 0.36 | 34.0 | 10.5 | 111.0 | True | speed | 30.955929896158715 | 9.28945579800418 | 104.72349548339844
fl_ankle | X8-32 9:1 | 0.55 | 32.0 | 8.0 | 277.0 | True | speed | 14.272491342655393 | 3.501642554490814 | 227.09469604492188
br_hip | X4-36 36:1 | 0.36 | 34.0 | 10.5 | 111.0 | True | peak torque | 12.099086537155673 | 3.7089946820929423 | 35.17333984375
br_knee | X4-36 36:1 | 0.36 | 34.0 | 10.5 | 111.0 | True | RMS torque | 20.744046164178283 | 8.488761637839785 | 67.24100494384766
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
