CarlitosssT/Tesis-Senecabot/simulacion/geometry_opt/results/motors_v140_PETG.csv

joint | model | mass | peak | nominal | speed | feasible | binding | req_peak | req_nominal | req_speed
fr_hip | X4-36 36:1 | 0.36 | 34.0 | 10.5 | 111.0 | True | peak torque | 26.510060687254093 | 6.761828845316439 | 69.7774429321289
fr_knee | X6-60 19,612:1 | 0.82 | 60.0 | 20.0 | 176.0 | True | speed | 43.172411388913886 | 10.50912528163051 | 160.27377319335938
fr_ankle | X8-32 9:1 | 0.55 | 32.0 | 8.0 | 277.0 | True | speed | 16.207455709185 | 4.141906412372661 | 178.30967712402344
fl_hip | X4-36 36:1 | 0.36 | 34.0 | 10.5 | 111.0 | True | peak torque | 22.704926749454884 | 6.777349842056146 | 42.039215087890625
fl_knee | X6-60 19,612:1 | 0.82 | 60.0 | 20.0 | 176.0 | True | speed | 54.87562236733912 | 11.745634093140628 | 162.8634490966797
fl_ankle | X8-32 9:1 | 0.55 | 32.0 | 8.0 | 277.0 | True | speed | 20.42299218565994 | 4.2579373458796805 | 181.51931762695312
br_hip | X4-36 36:1 | 0.36 | 34.0 | 10.5 | 111.0 | True | RMS torque | 15.522758709803158 | 4.975540024551257 | 31.76637077331543
br_knee | X4-36 36:1 | 0.36 | 34.0 | 10.5 | 111.0 | True | RMS torque | 26.856204133806084 | 9.463777883912934 | 61.40249252319336
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
