CarlitosssT/Tesis-Senecabot/simulacion/geometry_opt/results/linkage_v0218.csv

model | leg | r1 | r2 | f1 | f2 | l1 | l2 | l3 | l4 | dx | dy | a3_deg | rr1_branch | nominal_range_pct | extended_range_pct | theta1_min_deg | theta1_max_deg | theta2_min_deg | theta2_max_deg | gait_reached_pct | gait_no_overlap_pct
v0218 | FR | 0.111 | 0.1534 | 0.2 | 0.2 | 0.05774476585958051 | 0.017777231555303752 | 0.03894596847945979 | 0.1055087890548713 | 0.034667965766575215 | 0.03460607032502421 | -123.31976355704903 | 1 | 100.0 | 85.79881656804734 | -36.44314117066353 | -13.96040897031307 | -177.9361549788267 | -96.39777330875384 | 100.0 | 100.0
v0218 | BR | 0.231 | 0.148 | 0.2 | 0.2 | 0.035823653264848876 | 0.04288209303571727 | 0.2251949024827466 | 0.05199875581380304 | 0.034277068468332256 | 0.03519461092331382 | -136.7595773886229 | 1 | 100.0 | 86.3905325443787 | -165.18938957237125 | -142.45760135412544 | -126.9660117315791 | -66.20833376220288 | 100.0 | 100.0
