CarlitosssT/Tesis-Senecabot/simulacion/geometry_opt/results/linkage_v140.csv

model | leg | r1 | r2 | f1 | f2 | l1 | l2 | l3 | l4 | dx | dy | a3_deg | rr1_branch | nominal_range_pct | extended_range_pct | torque_amplification | theta1_min_deg | theta1_max_deg | theta2_min_deg | theta2_max_deg | gait_reached_pct | gait_no_overlap_pct
v140 | FR | 0.111 | 0.1534 | 0.5 | 0.2 | 0.04090662716949947 | 0.07152605495415779 | 0.03297699170042723 | 0.1104666794183531 | 0.03416414809725447 | 0.03468284699005271 | -134.73386064097247 | 1 | 100.0 | 82.24852071005917 | 1.5632248807108067 | -52.890113748649156 | -11.172431619046 | -180.8376671495723 | -92.73173757364121 | 100.0 | 100.0
v140 | BR | 0.231 | 0.148 | 0.3 | 0.5 | 0.03070720035830607 | 0.07234331188044227 | 0.20951826350358851 | 0.11141332723051481 | 0.03474037631159935 | 0.03472283939352805 | -117.39939835883992 | 1 | 100.0 | 100.0 | 4.169888959218346 | -167.19134192376407 | -137.12974302790826 | -131.69695592056678 | -53.70585690160215 | 100.0 | 100.0
