CarlitosssT/Tesis-Senecabot/simulacion/geometry_opt/results/linkage_v140_br_animation.gif

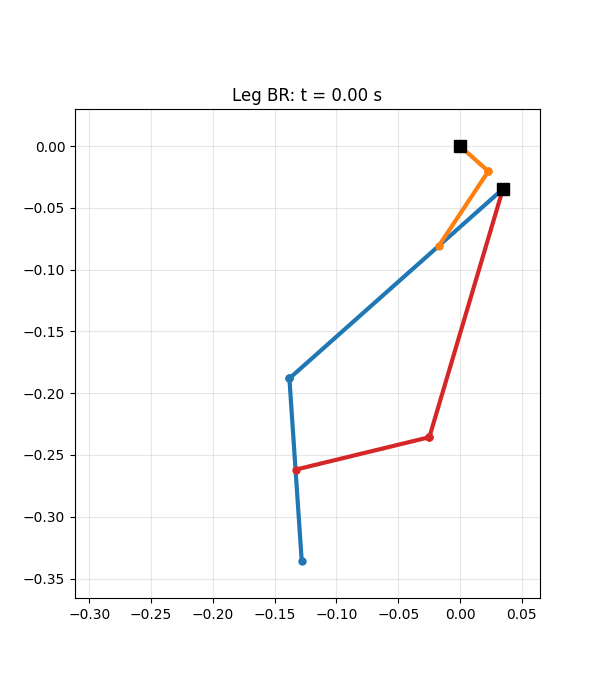
simulacion/geometry_opt/results/linkage_v140_br_animation.gif
