CarlitosssT/Tesis-Senecabot/simulacion/geometry_opt/results/linkage_v0218_fr_animation.gif

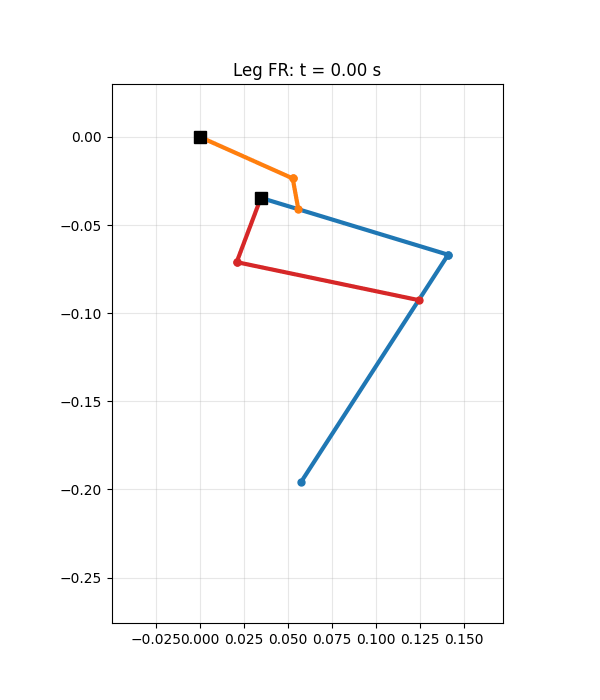
simulacion/geometry_opt/results/linkage_v0218_fr_animation.gif
