CarlitosssT/Tesis-Senecabot/simulacion/geometry_opt/results/rr_model_linkage.png

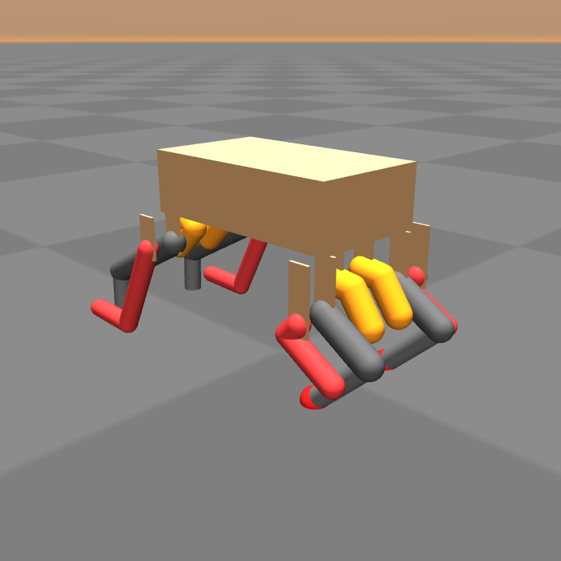
simulacion/geometry_opt/results/rr_model_linkage.png
