CarlitosssT/Tesis-Senecabot/simulacion/seneca_loco/final_document/images/error__validation_distances__grid.png

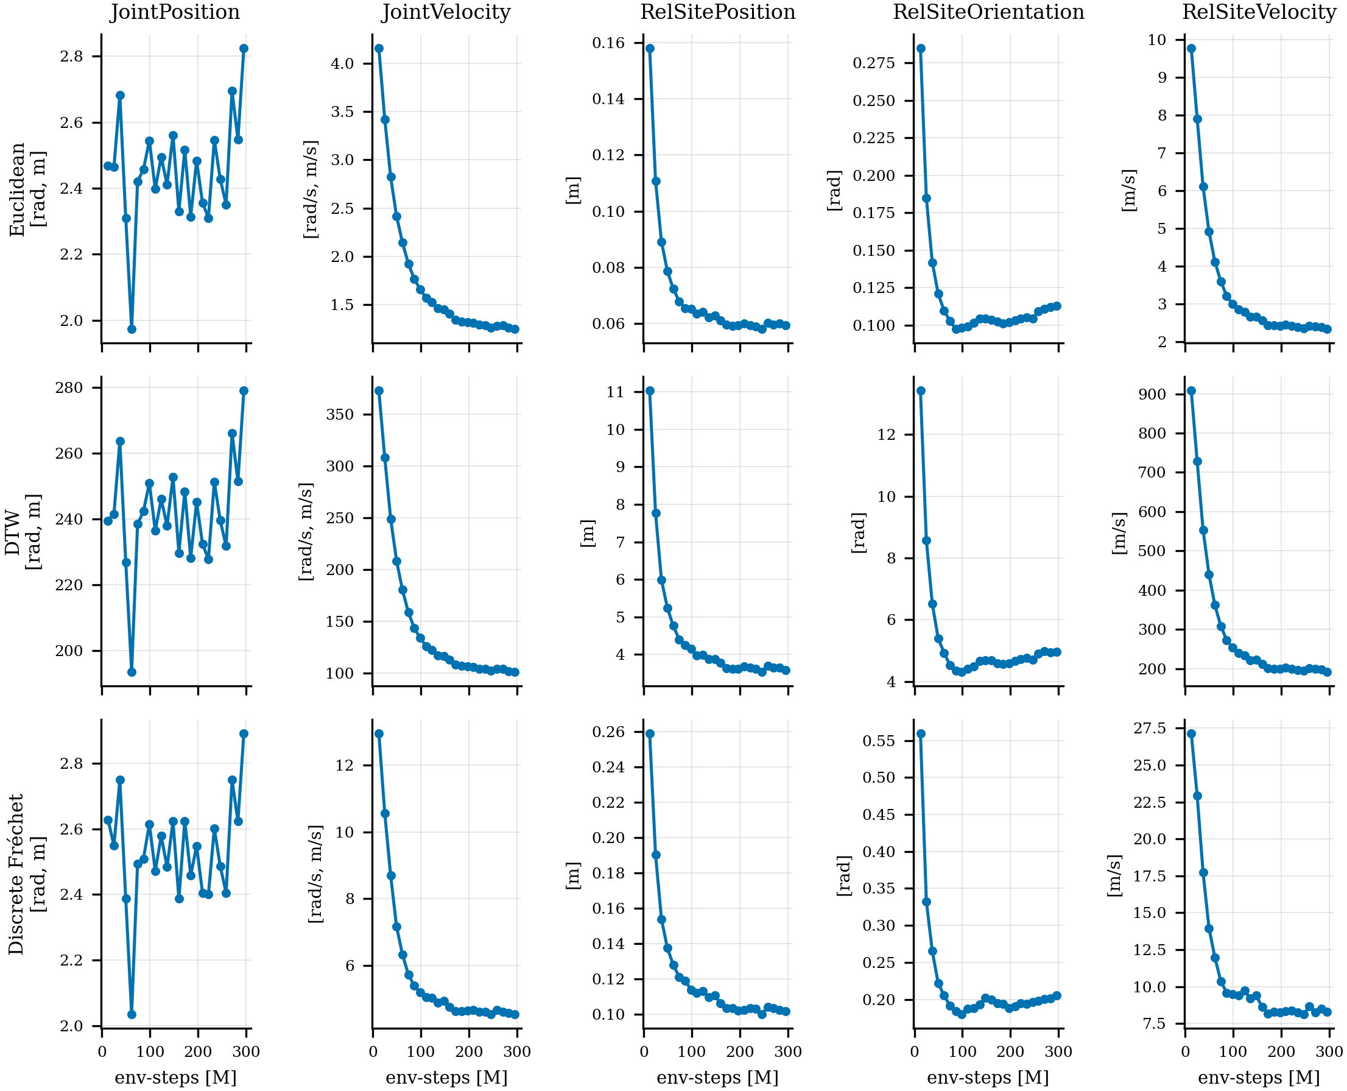
simulacion/seneca_loco/final_document/images/error__validation_distances__grid.png
