CarlitosssT/Tesis-Senecabot/(commit log)

2026-09-24 Initial commit: control y calibracion de patas del robot Eris
    Firmware ESP32 (PCA9685 + INA219), notebooks de control por Serial,
    captura de corriente y analisis/animacion de trayectorias articulares.
    [leg_actuator_angles_one_cycle.csv, leg_actuator_angles_trajectory_adapted.csv]
2026-09-28 Optimizacion de geometria SenecaBot: proyecto completo
    Incluye seneca_loco y loco-mujoco-seneca como carpetas normales (sin su
    historial de git), el pipeline geometry_opt, el analisis de microsaltos y
    el catalogo de actuadores. La tesis en PDF y el entorno virtual no se suben.
    [DFD_qvel.csv, DFD_site_rrotvec.csv, DFD_site_rvel.csv, DTW_qvel.csv, DTW_rrotvec.csv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]
2026-09-29 README: guía de instalación en Windows con WSL2 y VS Code
    Paso a paso desde la instalación de Ubuntu 24.04 en WSL2, comprobación de
    GPU, clonado del repo, entorno Python, verificación de JAX/MuJoCo y apertura
    del proyecto en VS Code en modo WSL, más notas para GPUs con poca VRAM.
    Claude-Session: https://claude.ai/code/session_016jyB7pGdf6757WTwLtJ5Kv
2026-09-29 Modulo de pendientes
2026-09-30 Pruebas de fine-tuning
2026-10-07 Revisar microsaltos de la pata trasera
2026-11-10 Pata RR: mecanismo de barras, modelo, entorno, agentes y CLAUDE.md raíz
    - geometry_opt: linkage.py (dimensionamiento de los mecanismos RR y motores
    a través del mecanismo) y make_rr_xml.py (genera senecabot_loco_rr.xml)
    - loco-mujoco-seneca: entorno SenecaBotRR; MimicReward con contact_ref_frac
    por pata, qacc_w y joint_limit_w
    - seneca_loco: trajectory_generation_rr, conf_rr / conf_rr_finetune,
    eval_rr, referencias RR y agentes RR (elegido 2026-11-04/17-37-28)
    - analisis_rr/: notebook, rollouts y GIFs de los agentes RR
    - CLAUDE.md en la raíz con el contexto completo del proyecto
    [linkage_actuators_v140_PLA.csv, linkage_v0218.csv, linkage_v140.csv]
2026-11-10 Reorganizar en simulacion/ y hardware/ y ajustar rutas
    - simulacion/: análisis agrupados en analisis/ (microsaltos, microsaltos_traseros,
    pata_rr, pendientes); "my actuator/" -> catalogo_myactuator/ (sin espacios).
    - hardware/: sketches de Arduino en firmware/; motor_sequence.py dentro de
    myactuator_esp32/; requirements.txt en hardware/.
    - Rutas corregidas en geometry_opt/config.py, hop_diagnosis.py, los docstrings de
    uso de los scripts de análisis y dos notebooks (patas_rr, visualize_slopes).
    - Valor por defecto de SENECA_HOME en los conf*.yaml apunta a la nueva ubicación.
    - Se quitan los __pycache__ versionados por error y se unifica el .gitignore.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
    [motors_MyActuator.xlsx, motors_MyActuator_Series_L_H.csv, motors_MyActuator_Series_L_H_X.csv]
2026-11-10 Documentación del repositorio unificado
    - README.md raíz: qué es el proyecto, mapa, "por dónde empiezo", inicio rápido,
    estado actual y créditos.
    - docs/: historia.md (cronología conjunta, resultados, dónde están los agentes,
    dos diseños de transmisión, pendientes), convenciones.md (patas, tres
    convenciones de ángulos, archivos que no se tocan, cómo documentar),
    glosario.md y rutas_antiguas.md.
    - simulacion/analisis/README.md nuevo.
    - README y CLAUDE.md de simulacion/ y hardware/ (y servos/README.md,
    geometry_opt/README.md) actualizados a las nuevas rutas e instalación.
    - CLAUDE.md raíz con el mapa para retomar el trabajo; entrada en el Change Log
    de seneca_loco/CL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
2026-11-10 Catálogo MyActuator: dimensiones, curvas características y motores nuevos
    Datos tomados de las páginas de descarga de las series X y L de MyActuator
    (fichas originales en catalogo_myactuator/fichas/).
    - Columnas nuevas en el CSV: diámetro, largo, radio y radio + 5 mm de holgura
    (29 motores), fuente de la dimensión y enlace a la curva característica.
    - curvas/: curva característica de 19 motores (10 desde el texto del PDF,
    5 transcritas de tablas en imagen y verificadas, 4 digitalizadas de la
    gráfica de la serie L); curvas/indice.csv documenta el origen de cada una.
    - Motores nuevos: X4-10-L, X4-36-L, X6-50-L, X8-150, X10-200, X15-450.
    X8-102 corregido a X8-120. xlsx sincroni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
    [L-4005.csv, L-4010.csv, L-4015.csv, L-5010.csv, L-7015.csv, L-7025.csv, L-9015.csv, L-9025.csv]
2026-11-11 SysID completo
    [ejecucion_cihrp_0x400.csv, ejecucion_multisine_0x400.csv, ejecucion_steps_0x400.csv]
2026-11-11 Documentar el modelo identificado del MyActuator
    README raíz y de hardware/, docs/historia.md (cronología y pendientes) y
    docs/rutas_antiguas.md (AGENTS.md). .gitignore: carpeta local de Codex.
    Claude-Session: https://claude.ai/code/session_01AUH1EduVDtpHXU5xMVmkh5
2026-11-11 Fine-tune RR con la función de transferencia del MyActuator
    - Fork: nueva función de control TFPDControl (control_functions/tf_pd.py).
    La acción comanda el ángulo de cada manivela (centro + a * semirrango);
    el comando pasa por G(s) = K/(tau s + 1) e^(-Td s) (retardo fraccional +
    primer orden exacto, K sobre el desplazamiento desde el centro) y un PD
    saturado al par del motor lo sigue. Por defecto, la G(s) del modo 0x400
    (tf_por_modo.json). Registrada en SENECA_LOCAL_CHANGES.md.
    - seneca_loco: conf_rr_finetune_tf.yaml (desde 17-37-28, referencia
    1.40 m/s, kp 3200 / kd 25, 100M pasos) y opción finetune.reset_actor_head
    en finetune.py (pone en cero la salida del actor cuando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
    [conf_rr_finetune_tf.yaml]
